cosmopotamian/DIY-LAPTOP/HARDWARE/A64-TERES/TERES-PCB1-A64-MAIN/Rev.C/TERES_PCB1-A64-MAIN_Rev.C.kicad_pcb

## KiCad design HARDWARE/A64-TERES/TERES-PCB1-A64-MAIN/Rev.C/TERES_PCB1-A64-MAIN_Rev.C.kicad_pcb (2025-03-08)

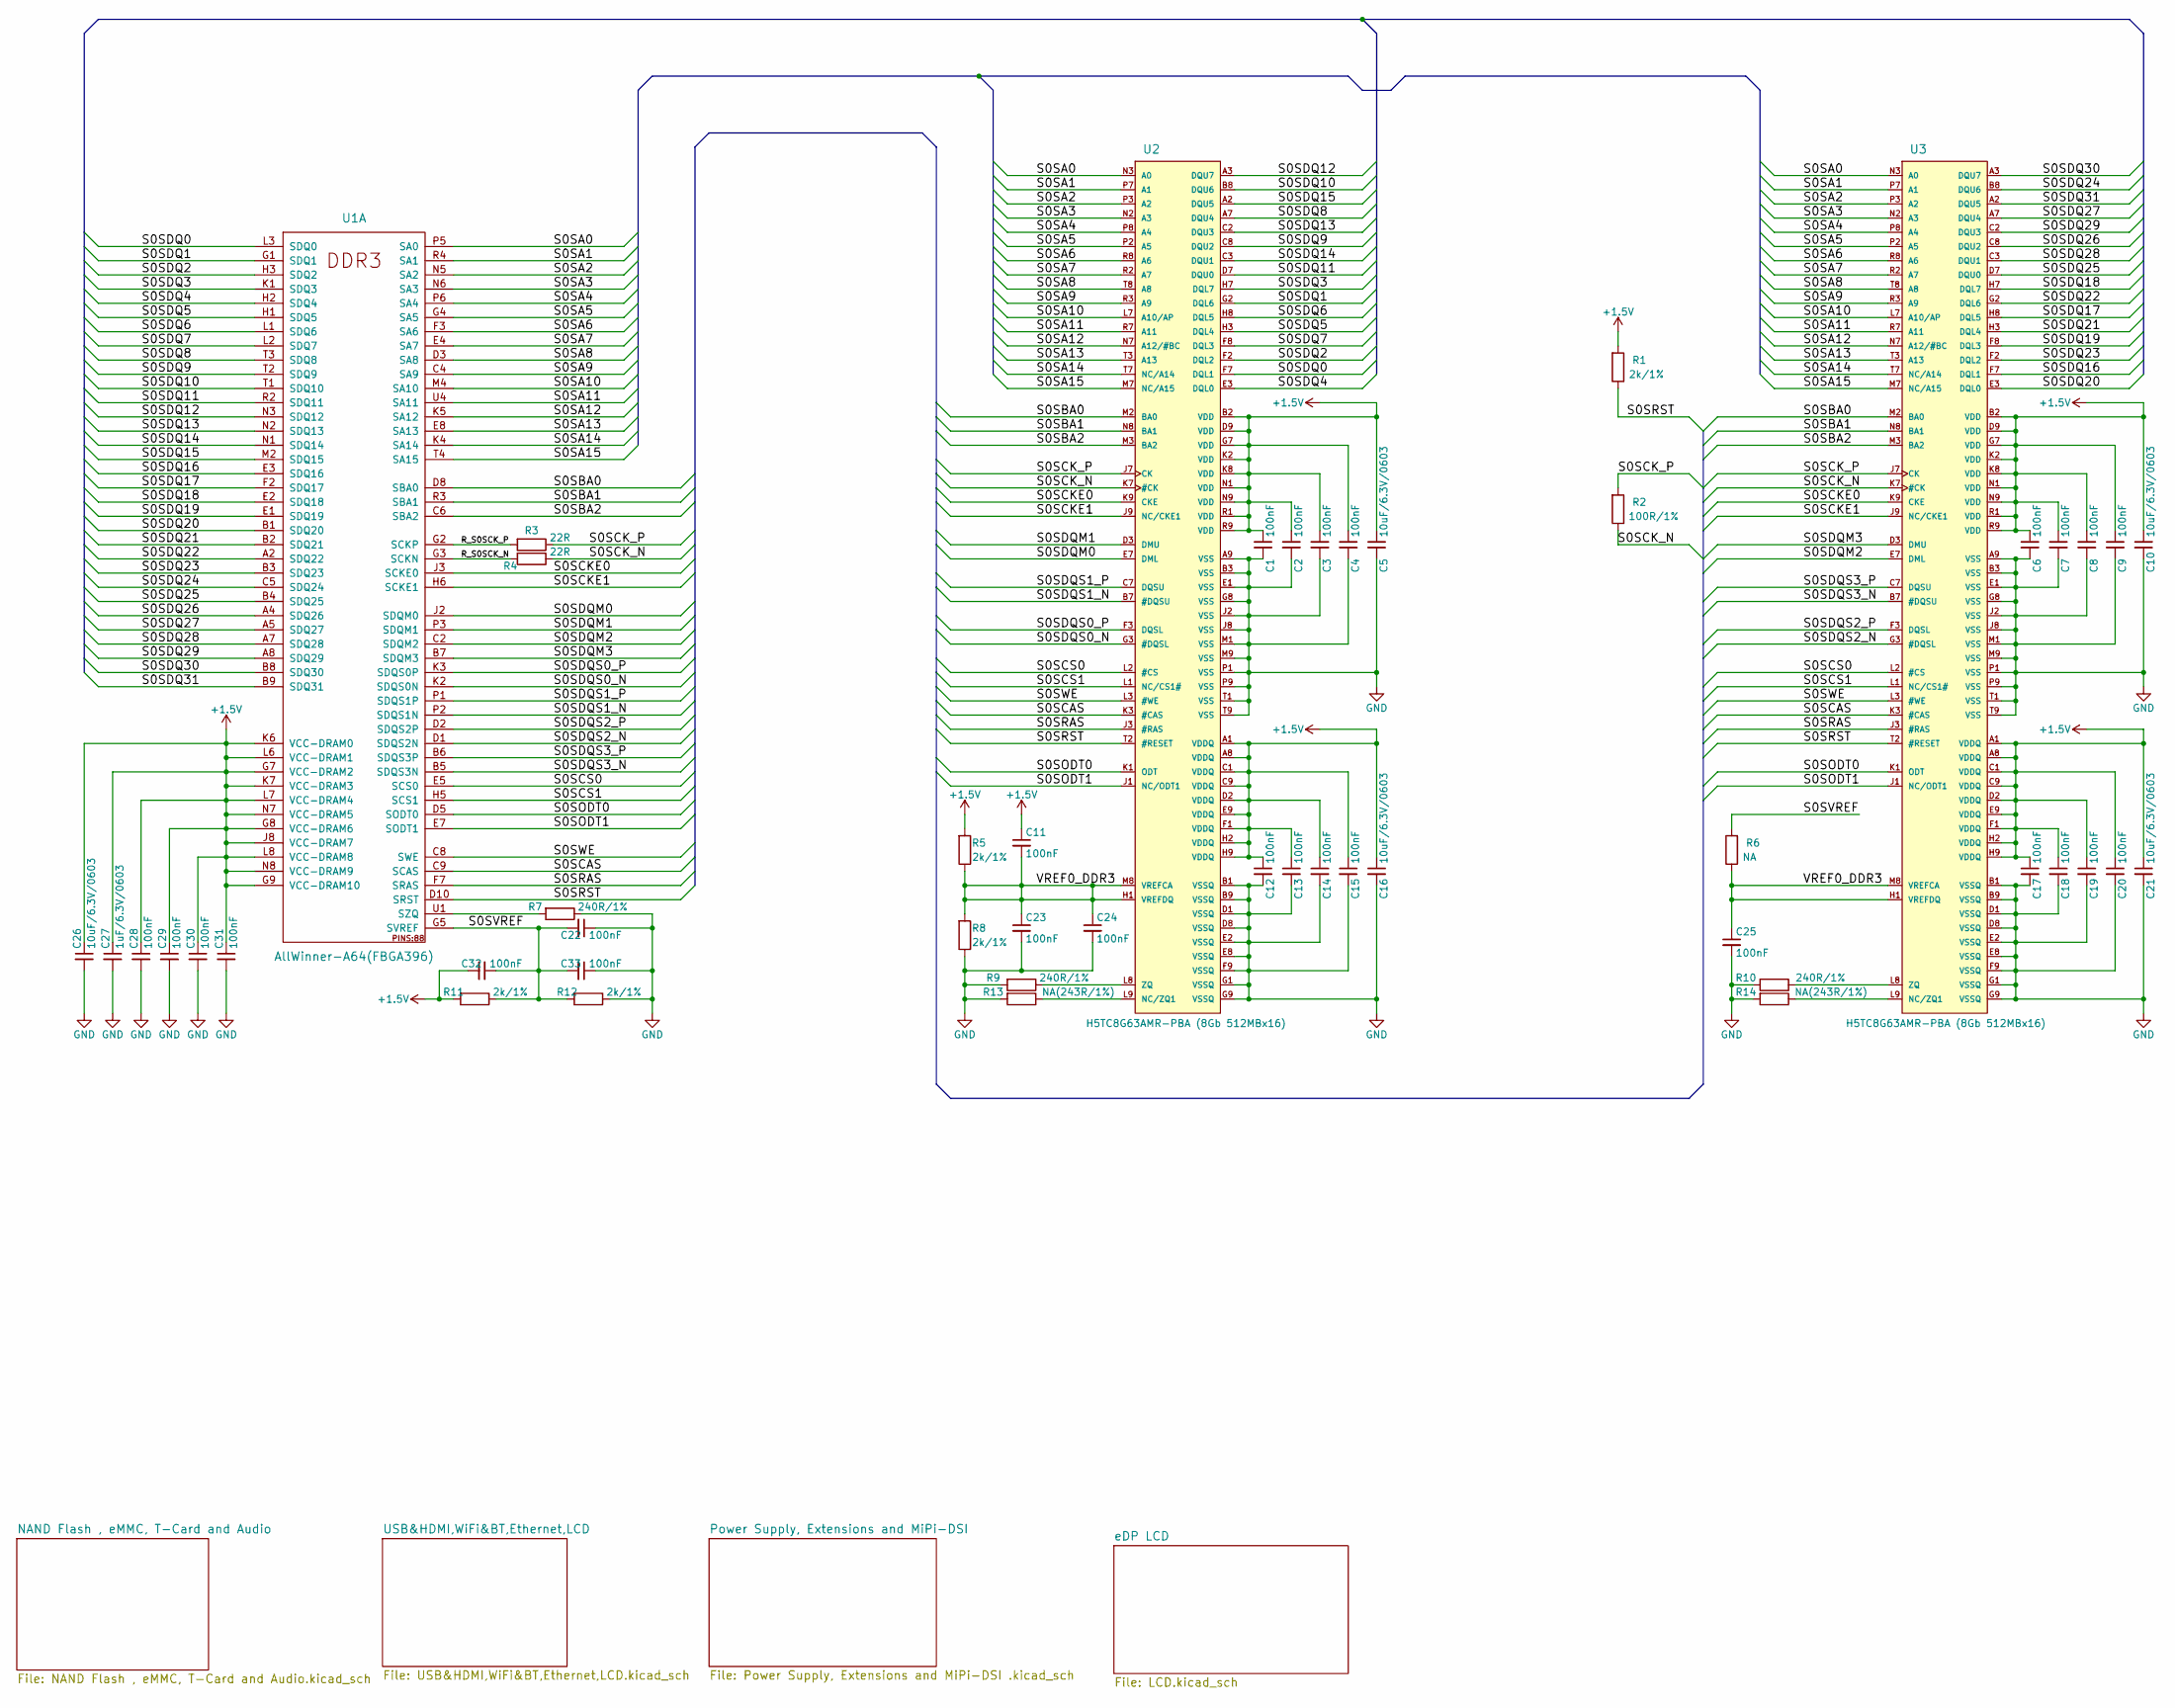
[picture p1: schematic TERES_PCB1-A64-MAIN_Rev.C.kicad_sch, A64-Teres]

Parts:
C1, C2, C3, C4, C6, C7, C8, C9, C11, C12, C13, C14, C15, C17, C18, C19, C20, C22, C23, C24, C25, C28, C29, C30, C31, C32, C33: 100nF; C_0402_5MIL_DWS
C5, C10, C16, C21, C26: 10uF/6.3V/0603; C_0603_5MIL_DWS
C27: 1uF/6.3V/0603; C_0603_5MIL_DWS
R1, R5, R8, R11, R12: 2k/1%; R_0402_5MIL_DWS
R2: 100R/1%; R_0402_5MIL_DWS
R3, R4: 22R; R_0402_5MIL_DWS
R6: NA; R_0402_5MIL_DWS
R7, R9, R10: 240R/1%; R_0402_5MIL_DWS
R13, R14: NA(243R/1%); R_0402_5MIL_DWS
U1: AllWinner-A64(FBGA396); FBGA396
U2, U3: H5TC8G63AMR-PBA (8Gb 512MBx16); FBGA96(HYNIX_SAMSUNG_512MX16_DDR3)

Connections:
+1.5V: C1.1, C2.1, C3.1, C4.1, C5.1, C6.1, C7.1, C8.1, C9.1, C10.1, C11.1, C12.1, C13.1, C14.1, C15.1, C16.1, C17.1, C18.1, C19.1, C20.1, C21.1, C26.1, C27.1, C28.1, C29.1, C30.1, C31.1, C32.2, R1.2, R5.2, R11.2, U1.G7 (VCC-DRAM2), U1.G8 (VCC-DRAM6), U1.G9 (VCC-DRAM10), U1.J8 (VCC-DRAM7), U1.K6 (VCC-DRAM0), U1.K7 (VCC-DRAM3), U1.L6 (VCC-DRAM1), U1.L7 (VCC-DRAM4), U1.L8 (VCC-DRAM8), U1.N7 (VCC-DRAM5), U1.N8 (VCC-DRAM9), U2.A1 (VDDQ), U2.A8 (VDDQ), U2.B2 (VDD), U2.C1 (VDDQ), U2.C9 (VDDQ), U2.D2 (VDDQ), U2.D9 (VDD), U2.E9 (VDDQ), U2.F1 (VDDQ), U2.G7 (VDD), U2.H2 (VDDQ), U2.H9 (VDDQ), U2.K2 (VDD), U2.K8 (VDD), U2.N1 (VDD), U2.N9 (VDD), U2.R1 (VDD), U2.R9 (VDD), U3.A1 (VDDQ), U3.A8 (VDDQ), U3.B2 (VDD), U3.C1 (VDDQ), U3.C9 (VDDQ), U3.D2 (VDDQ), U3.D9 (VDD), U3.E9 (VDDQ), U3.F1 (VDDQ), U3.G7 (VDD), U3.H2 (VDDQ), U3.H9 (VDDQ), U3.K2 (VDD), U3.K8 (VDD), U3.N1 (VDD), U3.N9 (VDD), U3.R1 (VDD), U3.R9 (VDD); also elsewhere on the board
/R_S0SCK_N: R4.2, U1.G3 (SCKN)
/R_S0SCK_P: R3.2, U1.G2 (SCKP)
/S0SA0: U1.P5 (SA0), U2.N3 (A0), U3.N3 (A0)
/S0SA1: U1.R4 (SA1), U2.P7 (A1), U3.P7 (A1)
/S0SA2: U1.N5 (SA2), U2.P3 (A2), U3.P3 (A2)
/S0SA3: U1.N6 (SA3), U2.N2 (A3), U3.N2 (A3)
/S0SA4: U1.P6 (SA4), U2.P8 (A4), U3.P8 (A4)
/S0SA5: U1.G4 (SA5), U2.P2 (A5), U3.P2 (A5)
/S0SA6: U1.F3 (SA6), U2.R8 (A6), U3.R8 (A6)
/S0SA7: U1.E4 (SA7), U2.R2 (A7), U3.R2 (A7)
/S0SA8: U1.D3 (SA8), U2.T8 (A8), U3.T8 (A8)
/S0SA9: U1.C4 (SA9), U2.R3 (A9), U3.R3 (A9)
/S0SA10: U1.M4 (SA10), U2.L7 (A10/AP), U3.L7 (A10/AP)
/S0SA11: U1.U4 (SA11), U2.R7 (A11), U3.R7 (A11)
/S0SA12: U1.K5 (SA12), U2.N7 (A12/#BC), U3.N7 (A12/#BC)
/S0SA13: U1.E8 (SA13), U2.T3 (A13), U3.T3 (A13)
/S0SA14: U1.K4 (SA14), U2.T7 (NC/A14), U3.T7 (NC/A14)
/S0SA15: U1.T4 (SA15), U2.M7 (NC/A15), U3.M7 (NC/A15)
/S0SBA0: U1.D8 (SBA0), U2.M2 (BA0), U3.M2 (BA0)
/S0SBA1: U1.R3 (SBA1), U2.N8 (BA1), U3.N8 (BA1)
/S0SBA2: U1.C6 (SBA2), U2.M3 (BA2), U3.M3 (BA2)
/S0SCAS: U1.C9 (SCAS), U2.K3 (#CAS), U3.K3 (#CAS)
/S0SCKE0: U1.J3 (SCKE0), U2.K9 (CKE), U3.K9 (CKE)
/S0SCKE1: U1.H6 (SCKE1), U2.J9 (NC/CKE1), U3.J9 (NC/CKE1)
/S0SCK_N: R2.1, R4.1, U2.K7 (#CK), U3.K7 (#CK)
/S0SCK_P: R2.2, R3.1, U2.J7 (CK), U3.J7 (CK)
/S0SCS0: U1.E5 (SCS0), U2.L2 (#CS), U3.L2 (#CS)
/S0SCS1: U1.H5 (SCS1), U2.L1 (NC/CS1#), U3.L1 (NC/CS1#)
/S0SDQ0: U1.L3 (SDQ0), U2.F7 (DQL1)
/S0SDQ1: U1.G1 (SDQ1), U2.G2 (DQL6)
/S0SDQ2: U1.H3 (SDQ2), U2.F2 (DQL2)
/S0SDQ3: U1.K1 (SDQ3), U2.H7 (DQL7)
/S0SDQ4: U1.H2 (SDQ4), U2.E3 (DQL0)
/S0SDQ5: U1.H1 (SDQ5), U2.H3 (DQL4)
/S0SDQ6: U1.L1 (SDQ6), U2.H8 (DQL5)
/S0SDQ7: U1.L2 (SDQ7), U2.F8 (DQL3)
/S0SDQ8: U1.T3 (SDQ8), U2.A7 (DQU4)
/S0SDQ9: U1.T2 (SDQ9), U2.C8 (DQU2)
/S0SDQ10: U1.T1 (SDQ10), U2.B8 (DQU6)
/S0SDQ11: U1.R2 (SDQ11), U2.D7 (DQU0)
/S0SDQ12: U1.N3 (SDQ12), U2.A3 (DQU7)
/S0SDQ13: U1.N2 (SDQ13), U2.C2 (DQU3)
/S0SDQ14: U1.N1 (SDQ14), U2.C3 (DQU1)
/S0SDQ15: U1.M2 (SDQ15), U2.A2 (DQU5)
/S0SDQ16: U1.E3 (SDQ16), U3.F7 (DQL1)
/S0SDQ17: U1.F2 (SDQ17), U3.H8 (DQL5)
/S0SDQ18: U1.E2 (SDQ18), U3.H7 (DQL7)
/S0SDQ19: U1.E1 (SDQ19), U3.F8 (DQL3)
/S0SDQ20: U1.B1 (SDQ20), U3.E3 (DQL0)
/S0SDQ21: U1.B2 (SDQ21), U3.H3 (DQL4)
/S0SDQ22: U1.A2 (SDQ22), U3.G2 (DQL6)
/S0SDQ23: U1.B3 (SDQ23), U3.F2 (DQL2)
/S0SDQ24: U1.C5 (SDQ24), U3.B8 (DQU6)
/S0SDQ25: U1.B4 (SDQ25), U3.D7 (DQU0)
/S0SDQ26: U1.A4 (SDQ26), U3.C8 (DQU2)
/S0SDQ27: U1.A5 (SDQ27), U3.A7 (DQU4)
/S0SDQ28: U1.A7 (SDQ28), U3.C3 (DQU1)
/S0SDQ29: U1.A8 (SDQ29), U3.C2 (DQU3)
/S0SDQ30: U1.B8 (SDQ30), U3.A3 (DQU7)
/S0SDQ31: U1.B9 (SDQ31), U3.A2 (DQU5)
/S0SDQM0: U1.J2 (SDQM0), U2.E7 (DML)
/S0SDQM1: U1.P3 (SDQM1), U2.D3 (DMU)
/S0SDQM2: U1.C2 (SDQM2), U3.E7 (DML)
/S0SDQM3: U1.B7 (SDQM3), U3.D3 (DMU)
/S0SDQS0_N: U1.K2 (SDQS0N), U2.G3 (#DQSL)
/S0SDQS0_P: U1.K3 (SDQS0P), U2.F3 (DQSL)
/S0SDQS1_N: U1.P2 (SDQS1N), U2.B7 (#DQSU)
/S0SDQS1_P: U1.P1 (SDQS1P), U2.C7 (DQSU)
/S0SDQS2_N: U1.D1 (SDQS2N), U3.G3 (#DQSL)
/S0SDQS2_P: U1.D2 (SDQS2P), U3.F3 (DQSL)
/S0SDQS3_N: U1.B5 (SDQS3N), U3.B7 (#DQSU)
/S0SDQS3_P: U1.B6 (SDQS3P), U3.C7 (DQSU)
/S0SODT0: U1.D5 (SODT0), U2.K1 (ODT), U3.K1 (ODT)
/S0SODT1: U1.E7 (SODT1), U2.J1 (NC/ODT1), U3.J1 (NC/ODT1)
/S0SRAS: U1.F7 (SRAS), U2.J3 (#RAS), U3.J3 (#RAS)
/S0SRST: R1.1, U1.D10 (SRST), U2.T2 (#RESET), U3.T2 (#RESET)
/S0SVREF: C22.2, C32.1, C33.2, R6.2, R11.1, R12.2, U1.G5 (SVREF)
/S0SWE: U1.C8 (SWE), U2.L3 (#WE), U3.L3 (#WE)
/VREF0_DDR3: C11.2, C23.1, C24.1, C25.1, R5.1, R6.1, R8.2, U2.H1 (VREFDQ), U2.M8 (VREFCA), U3.H1 (VREFDQ), U3.M8 (VREFCA)
GND: C1.2, C2.2, C3.2, C4.2, C5.2, C6.2, C7.2, C8.2, C9.2, C10.2, C12.2, C13.2, C14.2, C15.2, C16.2, C17.2, C18.2, C19.2, C20.2, C21.2, C22.1, C23.2, C24.2, C25.2, C26.2, C27.2, C28.2, C29.2, C30.2, C31.2, C33.1, R7.1, R8.1, R9.2, R10.2, R12.1, R13.2, R14.2, U2.A9 (VSS), U2.B1 (VSSQ), U2.B3 (VSS), U2.B9 (VSSQ), U2.D1 (VSSQ), U2.D8 (VSSQ), U2.E1 (VSS), U2.E2 (VSSQ), U2.E8 (VSSQ), U2.F9 (VSSQ), U2.G1 (VSSQ), U2.G8 (VSS), U2.G9 (VSSQ), U2.J2 (VSS), U2.J8 (VSS), U2.M1 (VSS), U2.M9 (VSS), U2.P1 (VSS), U2.P9 (VSS), U2.T1 (VSS), U2.T9 (VSS), U3.A9 (VSS), U3.B1 (VSSQ), U3.B3 (VSS), U3.B9 (VSSQ), U3.D1 (VSSQ), U3.D8 (VSSQ), U3.E1 (VSS), U3.E2 (VSSQ), U3.E8 (VSSQ), U3.F9 (VSSQ), U3.G1 (VSSQ), U3.G8 (VSS), U3.G9 (VSSQ), U3.J2 (VSS), U3.J8 (VSS), U3.M1 (VSS), U3.M9 (VSS), U3.P1 (VSS), U3.P9 (VSS), U3.T1 (VSS), U3.T9 (VSS); also elsewhere on the board
unnamed: R7.2, U1.U1 (SZQ)
unnamed: R9.1, U2.L8 (ZQ)
unnamed: R10.1, U3.L8 (ZQ)
unnamed: R13.1, U2.L9 (NC/ZQ1)
unnamed: R14.1, U3.L9 (NC/ZQ1)

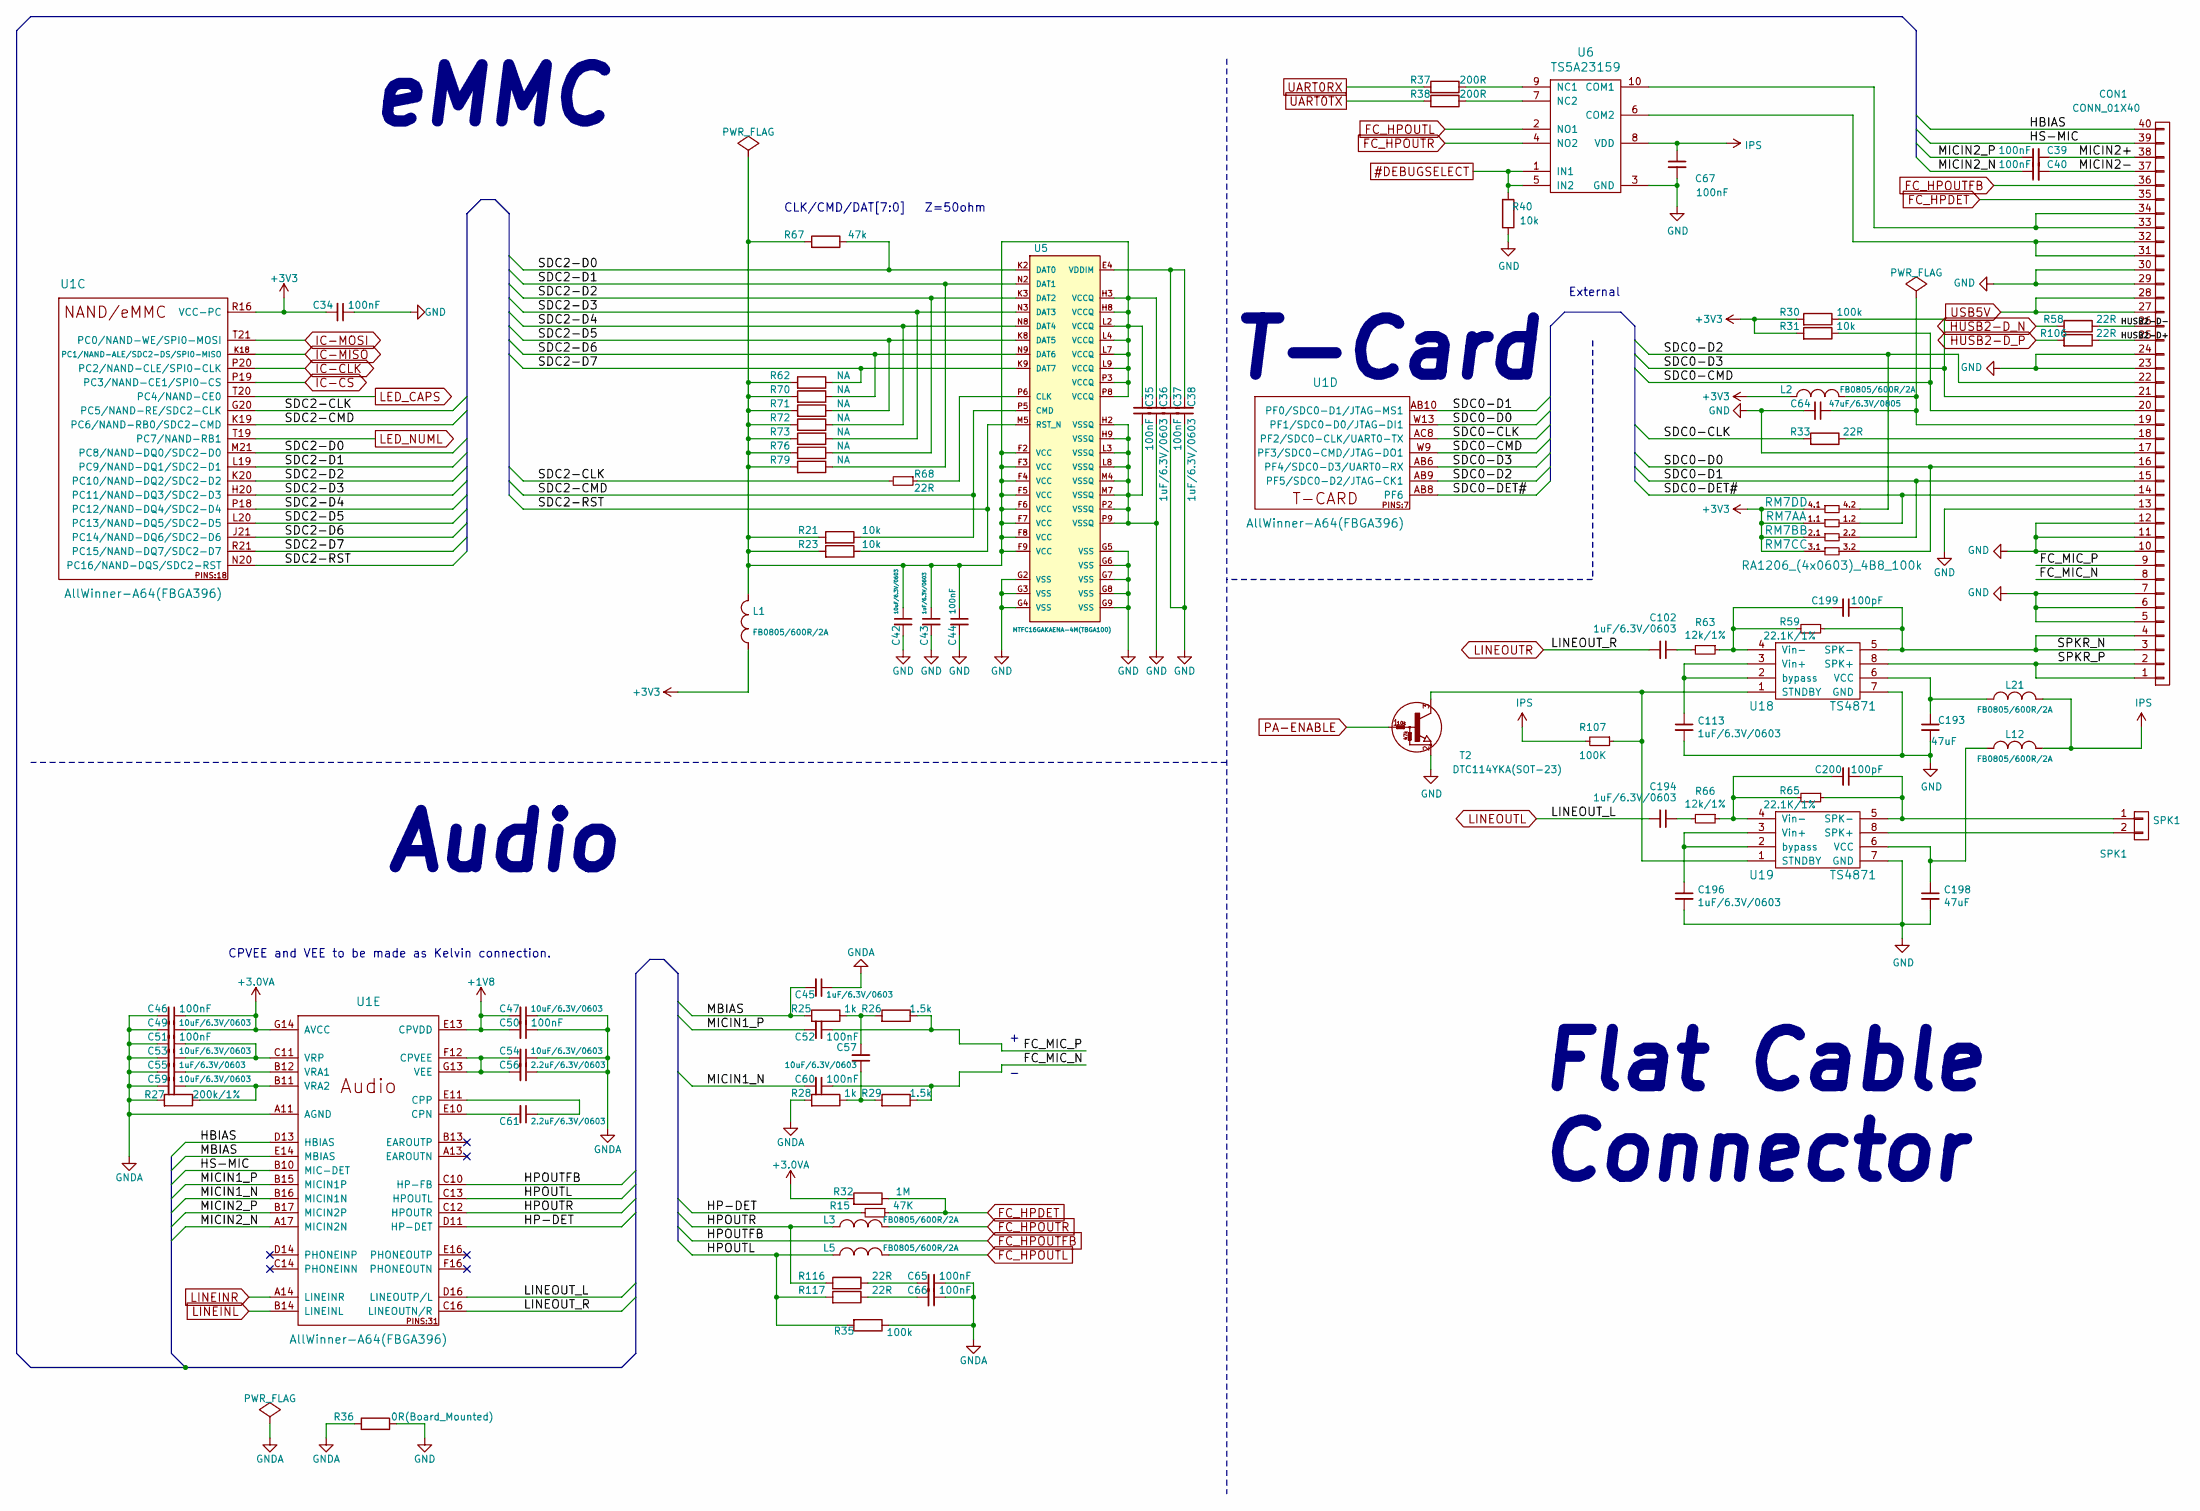
[picture p2: schematic NAND Flash , eMMC, T-Card and Audio.kicad_sch, A64-Teres]

Parts:
C34, C35, C37, C39, C40, C44, C46, C50, C51, C52, C60, C65, C66, C67: 100nF; C_0402_5MIL_DWS
C36, C38, C43, C45, C55, C102, C113, C194, C196: 1uF/6.3V/0603; C_0603_5MIL_DWS
C42, C47, C49, C53, C54, C57, C59: 10uF/6.3V/0603; C_0603_5MIL_DWS
C56, C61: 2.2uF/6.3V/0603; C_0603_5MIL_DWS
C64: 47uF/6.3V/0805; C_0805_5MIL_DWS
C193, C198: 47uF; C_0805_5MIL_DWS
C199, C200: 100pF; C_0402_5MIL_DWS
CON1: CONN_01X40; FPV-WZA21-40-LF
L1, L2, L3, L5, L12, L21: FB0805/600R/2A; L_0805_5MIL_DWS
R15: 47K; R_0402_5MIL_DWS
R21, R23, R31, R40: 10k; R_0402_5MIL_DWS
R25, R28: 1k; R_0402_5MIL_DWS
R26, R29: 1.5k; R_0402_5MIL_DWS
R27: 200k/1%; R_0402_5MIL_DWS
R30, R35: 100k; R_0402_5MIL_DWS
R32: 1M; R_0402_5MIL_DWS
R33, R58, R68, R106, R116, R117: 22R; R_0402_5MIL_DWS
R36: 0R(Board_Mounted); 0R_0603
R37, R38: 200R; R_0402_5MIL_DWS
R59, R65: 22.1K/1%; R_0402_5MIL_DWS
R62, R70, R71, R72, R73, R76, R79: NA; R_0402_5MIL_DWS
R63, R66: 12k/1%; R_0402_5MIL_DWS
R67: 47k; R_0402_5MIL_DWS
R107: 100K; R_0402_5MIL_DWS
RM7A, RM7B: RA1206_(4x0603)_4B8_100k; R_MATRIX_4
RM7C, RM7D: RA1206_(4x0603)_4B8_100k; RA1206_(4X0603)_4B8_xx
SPK1: SPK1; CON-SPK-TERES
T2: DTC114YKA(SOT-23); SOT23
U1: AllWinner-A64(FBGA396); FBGA396
U5: MTFC16GAKAENA-4M(TBGA100); TBGA100
U6: TS5A23159; VSSOP-10
U18, U19: TS4871; SO-8

Connections:
#DEBUGSELECT: R40.2, U6.1 (IN1), U6.5 (IN2); also elsewhere on the board
+1V8: C47.2, C50.2, U1.E13 (CPVDD); also elsewhere on the board
+3.0VA: C46.1, C49.1, R32.2, U1.G14 (AVCC); also elsewhere on the board
+3V3: C34.2, L1.1, L2.1, R30.2, R31.2, RM7A.1.1, RM7B.2.1, RM7C.3.1, RM7D.4.1, U1.R16 (VCC-PC); also elsewhere on the board
/NAND Flash , eMMC, T-Card and Audio/FC_MIC_N: C60.1, CON1.8, R29.1
/NAND Flash , eMMC, T-Card and Audio/FC_MIC_P: C52.1, CON1.9, R26.1
/NAND Flash , eMMC, T-Card and Audio/HBIAS: CON1.40, U1.D13 (HBIAS)
/NAND Flash , eMMC, T-Card and Audio/HP-DET: R15.2, U1.D11 (HP-DET)
/NAND Flash , eMMC, T-Card and Audio/HPOUTL: L5.1, R35.2, R117.2, U1.C13 (HPOUTL)
/NAND Flash , eMMC, T-Card and Audio/HPOUTR: L3.1, R116.2, U1.C12 (HPOUTR)
/NAND Flash , eMMC, T-Card and Audio/HS-MIC: CON1.39, U1.B10 (MIC-DET)
/NAND Flash , eMMC, T-Card and Audio/HUSB2-D+: CON1.25, R106.1
/NAND Flash , eMMC, T-Card and Audio/HUSB2-D-: CON1.26, R58.1
/NAND Flash , eMMC, T-Card and Audio/MBIAS: C45.2, R25.2, U1.E14 (MBIAS)
/NAND Flash , eMMC, T-Card and Audio/MICIN1_N: C60.2, U1.B16 (MICIN1N)
/NAND Flash , eMMC, T-Card and Audio/MICIN1_P: C52.2, U1.B15 (MICIN1P)
/NAND Flash , eMMC, T-Card and Audio/MICIN2+: C39.2, CON1.38
/NAND Flash , eMMC, T-Card and Audio/MICIN2-: C40.2, CON1.37
/NAND Flash , eMMC, T-Card and Audio/MICIN2_N: C40.1, U1.A17 (MICIN2N)
/NAND Flash , eMMC, T-Card and Audio/MICIN2_P: C39.1, U1.B17 (MICIN2P)
/NAND Flash , eMMC, T-Card and Audio/SDC0-CLK: R33.2, U1.AC8 (PF2/SDC0-CLK/UART0-TX)
/NAND Flash , eMMC, T-Card and Audio/SDC0-CMD: CON1.20, R31.1, U1.W9 (PF3/SDC0-CMD/JTAG-DO1)
/NAND Flash , eMMC, T-Card and Audio/SDC0-D0: CON1.16, RM7C.3.2, U1.W13 (PF1/SDC0-D0/JTAG-DI1); also elsewhere on the board
/NAND Flash , eMMC, T-Card and Audio/SDC0-D1: CON1.15, RM7B.2.2, U1.AB10 (PF0/SDC0-D1/JTAG-MS1); also elsewhere on the board
/NAND Flash , eMMC, T-Card and Audio/SDC0-D2: CON1.22, RM7D.4.2, U1.AB9 (PF5/SDC0-D2/JTAG-CK1); also elsewhere on the board
/NAND Flash , eMMC, T-Card and Audio/SDC0-D3: CON1.21, R30.1, U1.AB6 (PF4/SDC0-D3/UART0-RX)
/NAND Flash , eMMC, T-Card and Audio/SDC0-DET#: CON1.14, RM7A.1.2, U1.AB8 (PF6); also elsewhere on the board
/NAND Flash , eMMC, T-Card and Audio/SDC2-CLK: R68.2, U1.G20 (PC5/NAND-RE/SDC2-CLK)
/NAND Flash , eMMC, T-Card and Audio/SDC2-CMD: R21.1, U1.K19 (PC6/NAND-RB0/SDC2-CMD), U5.P5 (CMD)
/NAND Flash , eMMC, T-Card and Audio/SDC2-D0: R67.1, U1.M21 (PC8/NAND-DQ0/SDC2-D0), U5.K2 (DAT0)
/NAND Flash , eMMC, T-Card and Audio/SDC2-D1: R79.1, U1.L19 (PC9/NAND-DQ1/SDC2-D1), U5.N2 (DAT1)
/NAND Flash , eMMC, T-Card and Audio/SDC2-D2: R76.1, U1.K20 (PC10/NAND-DQ2/SDC2-D2), U5.K3 (DAT2)
/NAND Flash , eMMC, T-Card and Audio/SDC2-D3: R73.1, U1.H20 (PC11/NAND-DQ3/SDC2-D3), U5.N3 (DAT3)
/NAND Flash , eMMC, T-Card and Audio/SDC2-D4: R72.1, U1.P18 (PC12/NAND-DQ4/SDC2-D4), U5.N8 (DAT4)
/NAND Flash , eMMC, T-Card and Audio/SDC2-D5: R71.1, U1.L20 (PC13/NAND-DQ5/SDC2-D5), U5.K8 (DAT5)
/NAND Flash , eMMC, T-Card and Audio/SDC2-D6: R70.1, U1.J21 (PC14/NAND-DQ6/SDC2-D6), U5.N9 (DAT6)
/NAND Flash , eMMC, T-Card and Audio/SDC2-D7: R62.1, U1.R21 (PC15/NAND-DQ7/SDC2-D7), U5.K9 (DAT7)
/NAND Flash , eMMC, T-Card and Audio/SDC2-RST: R23.1, U1.N20 (PC16/NAND-DQS/SDC2-RST), U5.M5 (RST_N)
/NAND Flash , eMMC, T-Card and Audio/SPKR_N: C199.1, CON1.3, CON1.4, R59.1, U18.5 (SPK-)
/NAND Flash , eMMC, T-Card and Audio/SPKR_P: CON1.1, CON1.2, U18.8 (SPK+)
FC_HPDET: CON1.35, R15.1, R32.1
FC_HPOUTFB: CON1.36, U1.C10 (HP-FB)
FC_HPOUTL: L5.2, U6.2 (NO1)
FC_HPOUTR: L3.2, U6.4 (NO2)
GND: C34.1, C35.1, C36.1, C37.1, C38.1, C42.2, C43.2, C44.2, C64.2, C67.2, C113.2, C193.2, C196.2, C198.2, CON1.0, CON1.5, CON1.6, CON1.7, CON1.10, CON1.11, CON1.12, CON1.13, CON1.17, CON1.23, CON1.24, CON1.29, CON1.30, R36.1, R40.1, SPK1.0, T2.2 (E), U5.G2 (VSS), U5.G3 (VSS), U5.G4 (VSS), U5.G5 (VSS), U5.G6 (VSS), U5.G7 (VSS), U5.G8 (VSS), U5.G9 (VSS), U5.H2 (VSSQ), U5.H9 (VSSQ), U5.L3 (VSSQ), U5.L8 (VSSQ), U5.M4 (VSSQ), U5.M7 (VSSQ), U5.P2 (VSSQ), U5.P9 (VSSQ), U6.3 (GND), U18.7 (GND), U19.7 (GND); also elsewhere on the board
GNDA: C45.1, C46.2, C47.1, C49.2, C50.1, C51.2, C53.2, C54.1, C55.2, C56.1, C59.2, C65.1, C66.1, R27.2, R28.2, R35.1, R36.2, U1.A11 (AGND)
HUSB2-D_N: R58.2; also elsewhere on the board
HUSB2-D_P: R106.2; also elsewhere on the board
IC-CLK: U1.P20 (PC2/NAND-CLE/SPI0-CLK); also elsewhere on the board
IC-CS: U1.P19 (PC3/NAND-CE1/SPI0-CS); also elsewhere on the board
IC-MISO: U1.K18 (PC1/NAND-ALE/SDC2-DS/SPI0-MISO); also elsewhere on the board
IC-MOSI: U1.T21 (PC0/NAND-WE/SPI0-MOSI); also elsewhere on the board
IPS: C67.1, L12.2, L21.2, R107.2, U6.8 (VDD); also elsewhere on the board
LED_CAPS: U1.T20 (PC4/NAND-CE0); also elsewhere on the board
LED_NUML: U1.T19 (PC7/NAND-RB1); also elsewhere on the board
LINEINL: U1.B14 (LINEINL); also elsewhere on the board
LINEINR: U1.A14 (LINEINR); also elsewhere on the board
LINEOUTL: C194.2, U1.D16 (LINEOUTP/L); also elsewhere on the board
LINEOUTR: C102.2, U1.C16 (LINEOUTN/R); also elsewhere on the board
unnamed: C35.2, C36.2, C42.1, C43.1, C44.1, L1.2, R21.2, R23.2, R62.2, R67.2, R70.2, R71.2, R72.2, R73.2, R76.2, R79.2, U5.F2 (VCC), U5.F3 (VCC), U5.F4 (VCC), U5.F5 (VCC), U5.F6 (VCC), U5.F7 (VCC), U5.F8 (VCC), U5.F9 (VCC), U5.H3 (VCCQ), U5.H8 (VCCQ), U5.L2 (VCCQ), U5.L4 (VCCQ), U5.L7 (VCCQ), U5.L9 (VCCQ), U5.P3 (VCCQ), U5.P8 (VCCQ)
unnamed: C37.2, C38.2, U5.E4 (VDDIM)
unnamed: C51.1, C53.1, U1.C11 (VRP)
unnamed: C54.2, C56.2, U1.F12 (CPVEE), U1.G13 (VEE)
unnamed: C55.1, U1.B12 (VRA1)
unnamed: C57.1, R28.1, R29.2
unnamed: C57.2, R25.1, R26.2
unnamed: C59.1, R27.1, U1.B11 (VRA2)
unnamed: C61.1, U1.E11 (CPP)
unnamed: C61.2, U1.E10 (CPN)
unnamed: C64.1, CON1.19, L2.2
unnamed: C65.2, R116.1
unnamed: C66.2, R117.1
unnamed: C102.1, R63.2
unnamed: C113.1, U18.2 (bypass), U18.3 (Vin+)
unnamed: C193.1, L21.1, U18.6 (VCC)
unnamed: C194.1, R66.2
unnamed: C196.1, U19.2 (bypass), U19.3 (Vin+)
unnamed: C198.1, L12.1, U19.6 (VCC)
unnamed: C199.2, R59.2, R63.1, U18.4 (Vin-)
unnamed: C200.1, R65.1, SPK1.1, U19.5 (SPK-)
unnamed: C200.2, R65.2, R66.1, U19.4 (Vin-)
unnamed: CON1.18, R33.1
unnamed: CON1.31, CON1.32, U6.6 (COM2)
unnamed: CON1.33, CON1.34, U6.10 (COM1)
unnamed: R37.1, U6.9 (NC1)
unnamed: R38.1, U6.7 (NC2)
unnamed: R68.1, U5.P6 (CLK)
unnamed: R107.1, T2.3 (C), U18.1 (STNDBY), U19.1 (STNDBY)
unnamed: SPK1.2, U19.8 (SPK+)
PA-ENABLE: T2.1 (B); also elsewhere on the board
UART0RX: R37.2; also elsewhere on the board
UART0TX: R38.2; also elsewhere on the board
USB5V: CON1.27, CON1.28; also elsewhere on the board

Notes on the sheet:
Audio
T-Card
CPVEE and VEE to be made as Kelvin connection.
CLK/CMD/DAT[7:0] Z=50ohm
External
eMMC
Flat Cable Connector
