cosmopotamian/DIY-LAPTOP/HARDWARE/A64-TERES/TERES-PCB1-A64-MAIN/Rev.C/TERES_PCB1-A64-MAIN_Rev.C.kicad_pcb

## KiCad design HARDWARE/A64-TERES/TERES-PCB1-A64-MAIN/Rev.C/TERES_PCB1-A64-MAIN_Rev.C.kicad_pcb (continued)

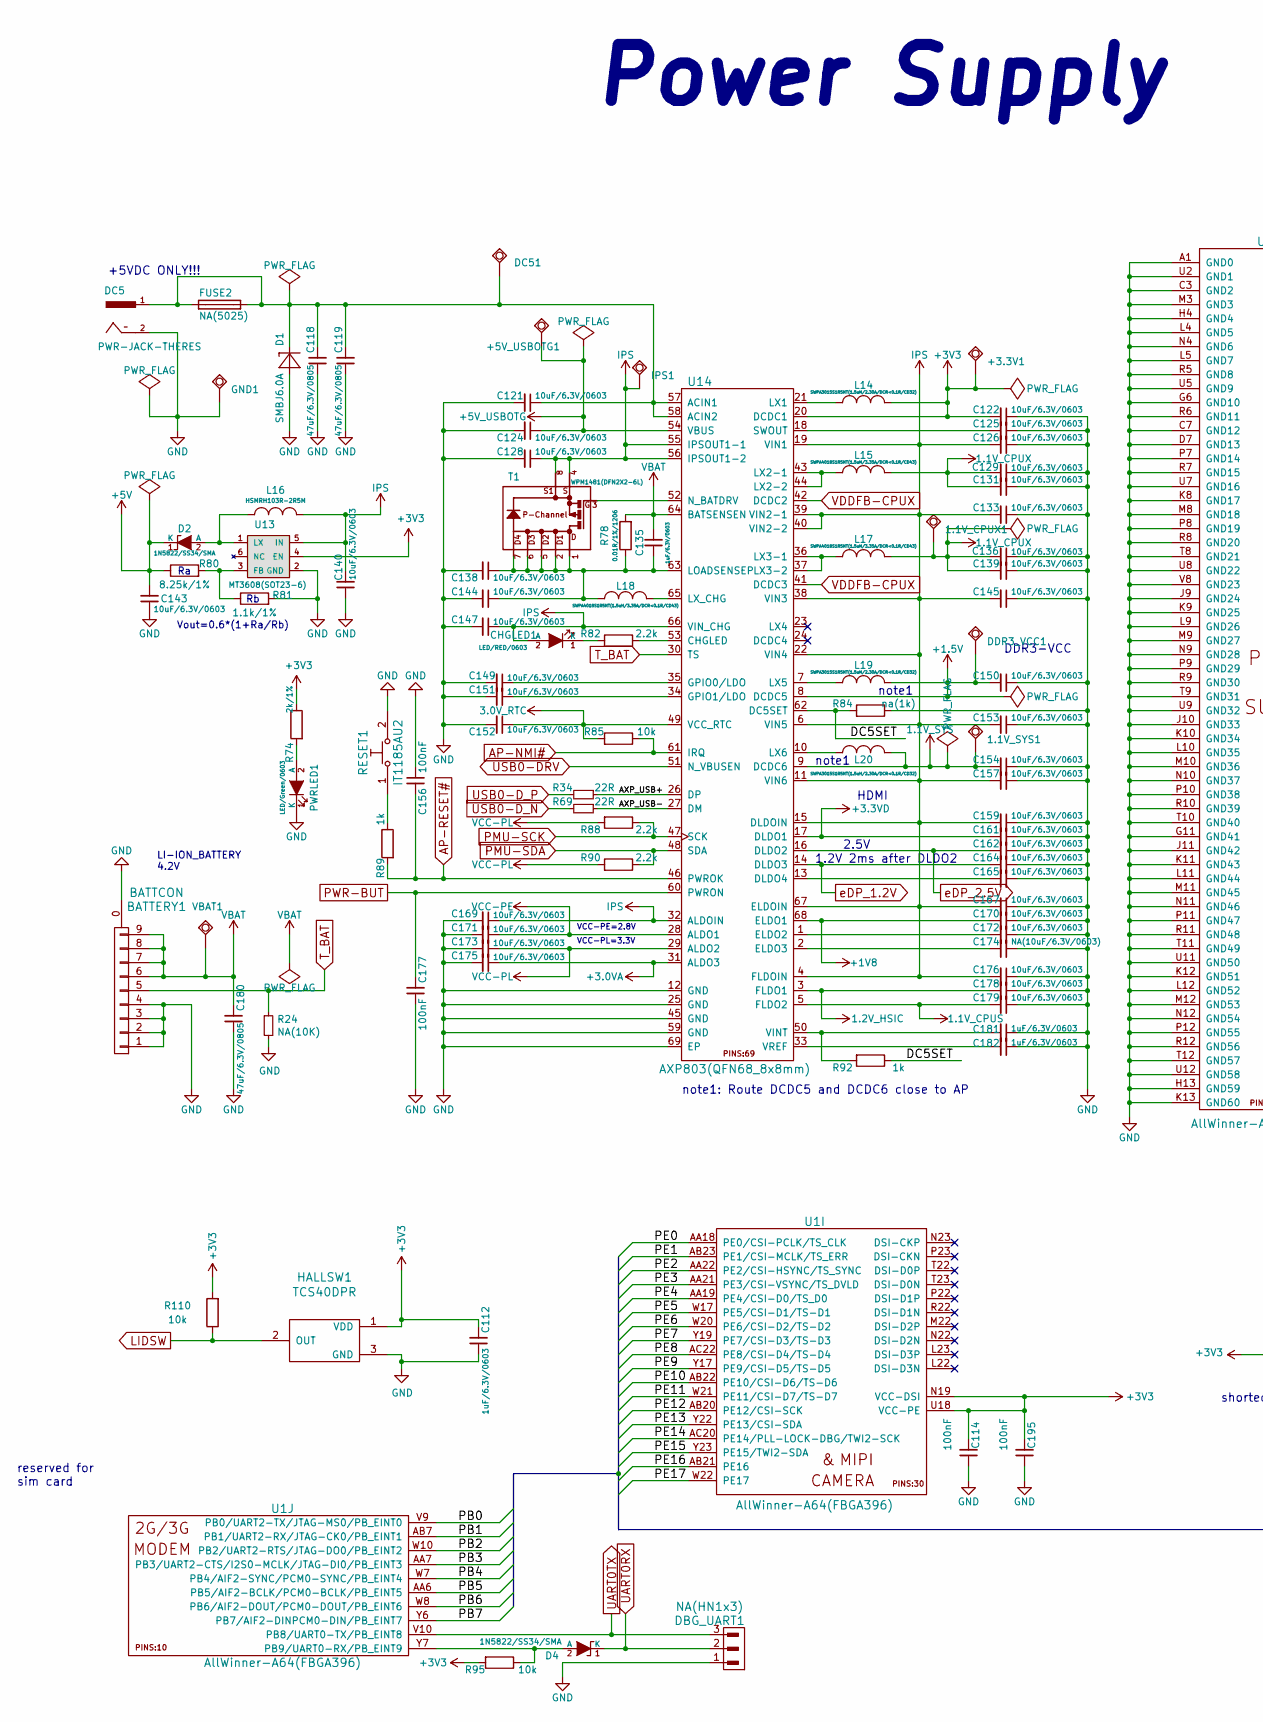
[picture p3: schematic Power Supply, Extensions and MiPi-DSI .kicad_sch, A64-Teres, part in row 1, column 1]

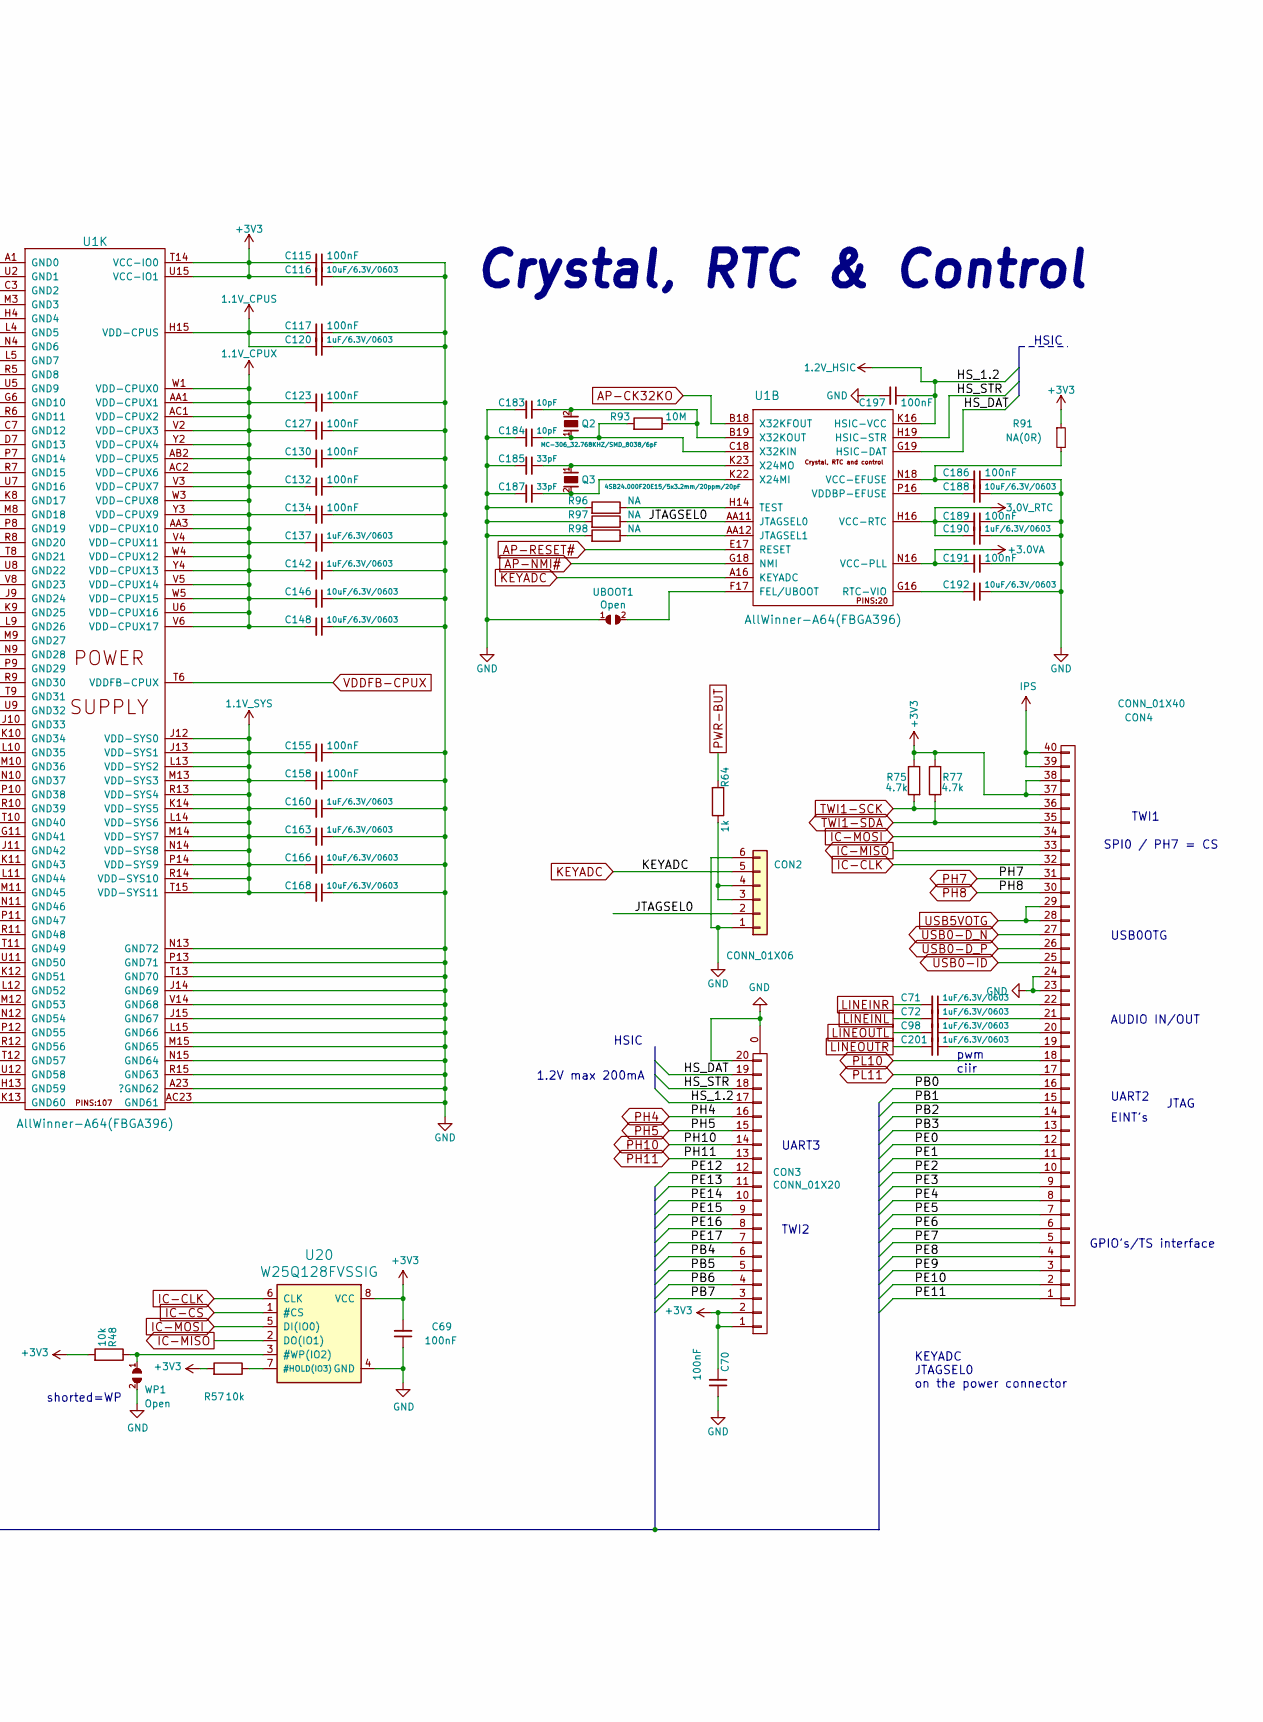
[picture p4: schematic Power Supply, Extensions and MiPi-DSI .kicad_sch, A64-Teres, part in row 1, column 2]

Parts:
1.1V_CPUX1, 1.1V_SYS1: TESTPAD; TESTPAD_40-ROUND
+3.3V1: TESTPAD; TESTPAD_40-ROUND
+5V_USBOTG1: +5V_USBOTG; TESTPAD_40-ROUND
BATTERY1: BATTCON; BATCONN-TERES
C69, C70, C114, C115, C117, C123, C127, C130, C132, C134, C155, C156, C158, C177, C186, C189, C191, C195, C197: 100nF; C_0402_5MIL_DWS
C71, C72, C98, C112, C120, C135, C137, C142, C160, C163, C181, C182, C190, C201: 1uF/6.3V/0603; C_0603_5MIL_DWS
C116, C121, C122, C124, C125, C126, C128, C129, C131, C133, C136, C138, C139, C140, C143, C144, C145, C146, C147, C148, C149, C150, C151, C152, C153, C154, C157, C159, C161, C162, C164, C165, C166, C167, C168, C169, C170, C171, C172, C173, C175, C176, C178, C179, C188, C192: 10uF/6.3V/0603; C_0603_5MIL_DWS
C118, C119, C180: 47uF/6.3V/0805; C_0805_5MIL_DWS
C174: NA(10uF/6.3V/0603); C_0603_5MIL_DWS
C183, C184: 10pF; C_0402_5MIL_DWS
C185, C187: 33pF; C_0402_5MIL_DWS
CHGLED1: LED/RED/0603; LED_0603_KA
CON2: CONN_01X06; FLEXCON-0.5-6
CON3: CONN_01X20; FPV-WZA21-20-LF
CON4: CONN_01X40; FPV-WZA21-40-LF
D1: SMBJ6.0A; DO214AA
D2, D4: 1N5822/SS34/SMA; SMA-KA
DBG_UART1: NA(HN1x3); HN1x3(SMD)
DC5: PWR-JACK-THERES; DC-055-TERES
DC51: TESTPAD; TESTPAD_40-ROUND
DDR3_VCC1: TESTPAD; TESTPAD_40-ROUND
FUSE2: NA(5025); FUSE-5025
GND1: TESTPAD; TESTPAD_40-ROUND
HALLSW1: TCS40DPR; SOT23
IPS1: TESTPAD; TESTPAD_40-ROUND
L14, L19, L20: SWPA3015S1R5NT(1.5uH/2.30A/DCR<0.1R/CD32); CD32
L15, L17, L18: SWPA4018S1R5NT(1.5uH/3.35A/DCR<0.1R/CD43); CD42(43)
L16: HSMRH103R-2R5M; HSMRH103R
PWRLED1: LED/Green/0603; LED_0603_KA
Q2: MC-306_32.768KHZ/SMD_8038/6pF; MC306-HS
Q3: 4SB24.000F20E15/5x3.2mm/20ppm/20pF; Q5x3.25
R24: NA(10K); R_0402_5MIL_DWS
R34, R69: 22R; R_0402_5MIL_DWS
R48, R57, R85, R95, R110: 10k; R_0402_5MIL_DWS
R64, R89, R92: 1k; R_0402_5MIL_DWS
R74: 2k/1%; R_0402_5MIL_DWS
R75, R77: 4.7k; R_0402_5MIL_DWS
R78: 0.01R/1%/1206; R_1206_5MIL_DWS
R80: 8.25k/1%; R_0402_5MIL_DWS
R81: 1.1k/1%; R_0402_5MIL_DWS
R82, R88, R90: 2.2k; R_0402_5MIL_DWS
R84: na(1k); R_0402_5MIL_DWS
R91: NA(0R); R_0402_5MIL_DWS
R93: 10M; R_0402_5MIL_DWS
R96, R97, R98: NA; R_0402_5MIL_DWS
RESET1: IT1185AU2; uTACTIL
T1: WPM1481(DFN2X2-6L); DFN2x2-6L
U1: AllWinner-A64(FBGA396); FBGA396
U13: MT3608(SOT23-6); SOT23-6
U14: AXP803(QFN68_8x8mm); QFN68
U20: W25Q128FVSSIG; SO-8_208mil
UBOOT1: Open; SJ
VBAT1: TESTPAD; TESTPAD_40-ROUND
WP1: Open; SJ

Connections:
1.1V_CPUS: C117.2, C120.2, C179.2, U1.H15 (VDD-CPUS), U14.5 (FLDO2)
1.1V_CPUX: 1.1V_CPUX1.1, C123.2, C127.2, C129.2, C130.2, C131.2, C132.2, C134.2, C136.2, C137.2, C139.2, C142.2, C146.2, C148.2, L15.2, L17.2, U1.AA1 (VDD-CPUX1), U1.AA3 (VDD-CPUX10), U1.AB2 (VDD-CPUX5), U1.AC1 (VDD-CPUX2), U1.AC2 (VDD-CPUX6), U1.U6 (VDD-CPUX16), U1.V2 (VDD-CPUX3), U1.V3 (VDD-CPUX7), U1.V4 (VDD-CPUX11), U1.V5 (VDD-CPUX14), U1.V6 (VDD-CPUX17), U1.W1 (VDD-CPUX0), U1.W3 (VDD-CPUX8), U1.W4 (VDD-CPUX12), U1.W5 (VDD-CPUX15), U1.Y2 (VDD-CPUX4), U1.Y3 (VDD-CPUX9), U1.Y4 (VDD-CPUX13)
1.1V_SYS: 1.1V_SYS1.1, C154.2, C155.2, C158.2, C160.2, C163.2, C166.2, C168.2, L20.2, U1.J12 (VDD-SYS0), U1.J13 (VDD-SYS1), U1.K14 (VDD-SYS5), U1.L13 (VDD-SYS2), U1.L14 (VDD-SYS6), U1.M13 (VDD-SYS3), U1.M14 (VDD-SYS7), U1.N14 (VDD-SYS8), U1.P14 (VDD-SYS9), U1.R13 (VDD-SYS4), U1.R14 (VDD-SYS10), U1.T15 (VDD-SYS11), U14.9 (DCDC6)
1.2V_HSIC: C178.2, C197.1, CON3.17, U1.K16 (HSIC-VCC), U14.3 (FLDO1)
3.0V_RTC: C152.1, C189.2, C190.2, R85.2, U1.H16 (VCC-RTC), U14.49 (VCC_RTC)
+1.5V: C150.2, DDR3_VCC1.1, L19.2, U14.8 (DCDC5); also elsewhere on the board
+1V8: C170.2, U14.68 (ELDO1); also elsewhere on the board
+3.0VA: C175.1, C191.2, U1.N16 (VCC-PLL), U14.31 (ALDO3); also elsewhere on the board
+3.3VD: C161.2, U14.17 (DLDO1); also elsewhere on the board
+3V3: +3.3V1.1, C69.2, C70.2, C112.2, C114.2, C115.2, C116.2, C122.2, C195.2, CON3.1, CON3.2, CON4.37, CON4.38, HALLSW1.1 (VDD), L14.2, R48.2, R57.2, R74.1, R75.1, R77.1, R91.1, R95.2, R110.2, U1.N19 (VCC-DSI), U1.T14 (VCC-IO0), U1.U15 (VCC-IO1), U1.U18 (VCC-PE), U13.4 (EN), U14.20 (DCDC1), U20.8 (VCC); also elsewhere on the board
+5V: C143.2, D2.1 (K), R80.1; also elsewhere on the board
/Power Supply, Extensions and MiPi-DSI/AXP_USB+: R34.1, U14.26 (DP)
/Power Supply, Extensions and MiPi-DSI/AXP_USB-: R69.1, U14.27 (DM)
/Power Supply, Extensions and MiPi-DSI/DC5SET: R84.2, R92.1, U14.62 (DC5SET)
/Power Supply, Extensions and MiPi-DSI/HS_DAT: CON3.19, U1.G19 (HSIC-DAT)
/Power Supply, Extensions and MiPi-DSI/HS_STR: CON3.18, U1.H19 (HSIC-STR)
/Power Supply, Extensions and MiPi-DSI/JTAGSEL0: CON2.2, R97.1, U1.AA11 (JTAGSEL0)
/Power Supply, Extensions and MiPi-DSI/PB0: CON4.16, U1.V9 (PB0/UART2-TX/JTAG-MS0/PB_EINT0)
/Power Supply, Extensions and MiPi-DSI/PB1: CON4.15, U1.AB7 (PB1/UART2-RX/JTAG-CK0/PB_EINT1)
/Power Supply, Extensions and MiPi-DSI/PB2: CON4.14, U1.W10 (PB2/UART2-RTS/JTAG-DO0/PB_EINT2)
/Power Supply, Extensions and MiPi-DSI/PB3: CON4.13, U1.AA7 (PB3/UART2-CTS/I2S0-MCLK/JTAG-DI0/PB_EIN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)
/Power Supply, Extensions and MiPi-DSI/PB4: CON3.6, U1.W7 (PB4/AIF2-SYNC/PCM0-SYNC/PB_EINT4)
/Power Supply, Extensions and MiPi-DSI/PB5: CON3.5, U1.AA6 (PB5/AIF2-BCLK/PCM0-BCLK/PB_EINT5)
/Power Supply, Extensions and MiPi-DSI/PB6: CON3.4, U1.W8 (PB6/AIF2-DOUT/PCM0-DOUT/PB_EINT6)
/Power Supply, Extensions and MiPi-DSI/PB7: CON3.3, U1.Y6 (PB7/AIF2-DINPCM0-DIN/PB_EINT7)
/Power Supply, Extensions and MiPi-DSI/PE0: CON4.12, U1.AA18 (PE0/CSI-PCLK/TS_CLK)
/Power Supply, Extensions and MiPi-DSI/PE1: CON4.11, U1.AB23 (PE1/CSI-MCLK/TS_ERR)
/Power Supply, Extensions and MiPi-DSI/PE2: CON4.10, U1.AA22 (PE2/CSI-HSYNC/TS_SYNC)
/Power Supply, Extensions and MiPi-DSI/PE3: CON4.9, U1.AA21 (PE3/CSI-VSYNC/TS_DVLD)
/Power Supply, Extensions and MiPi-DSI/PE4: CON4.8, U1.AA19 (PE4/CSI-D0/TS_D0)
/Power Supply, Extensions and MiPi-DSI/PE5: CON4.7, U1.W17 (PE5/CSI-D1/TS-D1)
/Power Supply, Extensions and MiPi-DSI/PE6: CON4.6, U1.W20 (PE6/CSI-D2/TS-D2)
/Power Supply, Extensions and MiPi-DSI/PE7: CON4.5, U1.Y19 (PE7/CSI-D3/TS-D3)
/Power Supply, Extensions and MiPi-DSI/PE8: CON4.4, U1.AC22 (PE8/CSI-D4/TS-D4)
/Power Supply, Extensions and MiPi-DSI/PE9: CON4.3, U1.Y17 (PE9/CSI-D5/TS-D5)
/Power Supply, Extensions and MiPi-DSI/PE10: CON4.2, U1.AB22 (PE10/CSI-D6/TS-D6)
/Power Supply, Extensions and MiPi-DSI/PE11: CON4.1, U1.W21 (PE11/CSI-D7/TS-D7)
/Power Supply, Extensions and MiPi-DSI/PE12: CON3.12, U1.AB20 (PE12/CSI-SCK)
/Power Supply, Extensions and MiPi-DSI/PE13: CON3.11, U1.Y22 (PE13/CSI-SDA)
/Power Supply, Extensions and MiPi-DSI/PE14: CON3.10, U1.AC20 (PE14/PLL-LOCK-DBG/TWI2-SCK)
/Power Supply, Extensions and MiPi-DSI/PE15: CON3.9, U1.Y23 (PE15/TWI2-SDA)
/Power Supply, Extensions and MiPi-DSI/PE16: CON3.8, U1.AB21 (PE16)
/Power Supply, Extensions and MiPi-DSI/PE17: CON3.7, U1.W22 (PE17)
AP-CK32KO: U1.B18 (X32KFOUT); also elsewhere on the board
AP-NMI#: R85.1, U1.G18 (NMI), U14.61 (IRQ)
AP-RESET#: C156.2, R89.2, U1.E17 (RESET), U14.46 (PWROK)
GND: BATTERY1.0, BATTERY1.1, BATTERY1.2, BATTERY1.3, BATTERY1.4, C69.1, C70.1, C112.1, C114.1, C115.1, C116.1, C117.1, C118.1, C119.1, C120.1, C121.2, C122.1, C123.1, C124.2, C125.1, C126.1, C127.1, C128.2, C129.1, C130.1, C131.1, C132.1, C133.1, C134.1, C136.1, C137.1, C138.2, C139.1, C140.1, C142.1, C143.1, C144.2, C145.1, C146.1, C147.2, C148.1, C149.2, C150.1, C151.2, C152.2, C153.1, C154.1, C155.1, C156.1, C157.1, C158.1, C159.1, C160.1, C161.1, C162.1, C163.1, C164.1, C165.1, C166.1, C167.1, C168.1, C169.2, C170.1, C171.2, C172.1, C173.2, C174.1, C175.2, C176.1, C177.1, C178.1, C179.1, C180.1, C181.1, C182.1, C183.2, C184.2, C185.2, C186.1, C187.2, C188.1, C189.1, C190.1, C191.1, C192.1, C195.1, C197.2, CON2.0, CON2.1, CON2.6, CON3.0, CON3.20, CON4.0, CON4.23, CON4.24, D1.A, DBG_UART1.1, DC5.2 (-), GND1.1, HALLSW1.3 (GND), PWRLED1.1 (K), R24.2, R81.2, R84.1, R96.2, R97.2, R98.2, RESET1.2, U1.A1 (GND0), U1.A23 (?GND62), U1.AC23 (GND61), U1.C3 (GND2), U1.C7 (GND12), U1.D7 (GND13), U1.G6 (GND10), U1.G11 (GND41), U1.H4 (GND4), U1.H13 (GND59), U1.J9 (GND24), U1.J10 (GND33), U1.J11 (GND42), U1.J14 (GND69), U1.J15 (GND67), U1.K8 (GND17), U1.K9 (GND25), U1.K10 (GND34), U1.K11 (GND43), U1.K12 (GND51), U1.K13 (GND60), U1.L4 (GND5), U1.L5 (GND7), U1.L9 (GND26), U1.L10 (GND35), U1.L11 (GND44), U1.L12 (GND52), U1.L15 (GND66), U1.M3 (GND3), U1.M8 (GND18), U1.M9 (GND27), U1.M10 (GND36), U1.M11 (GND45), U1.M12 (GND53), U1.M15 (GND65), U1.N4 (GND6), U1.N9 (GND28), U1.N10 (GND37), U1.N11 (GND46), U1.N12 (GND54), U1.N13 (GND72), U1.N15 (GND64), U1.P7 (GND14), U1.P8 (GND19), U1.P9 (GND29), U1.P10 (GND38), U1.P11 (GND47), U1.P12 (GND55), U1.P13 (GND71), U1.R5 (GND8), U1.R6 (GND11), U1.R7 (GND15), U1.R8 (GND20), U1.R9 (GND30), U1.R10 (GND39), U1.R11 (GND48), U1.R12 (GND56), U1.R15 (GND63), U1.T8 (GND21), U1.T9 (GND31), U1.T10 (GND40), U1.T11 (GND49), U1.T12 (GND57), U1.T13 (GND70), U1.U2 (GND1), U1.U5 (GND9), U1.U7 (GND16), U1.U8 (GND22), U1.U9 (GND32), U1.U11 (GND50), U1.U12 (GND58), U1.V8 (GND23), U1.V14 (GND68), U13.2 (GND), U14.12 (GND), U14.25 (GND), U14.45 (GND), U14.59 (GND), U14.69 (EP), U20.4 (GND), UBOOT1.1, WP1.2; also elsewhere on the board
IC-CLK: CON4.32, U20.6 (CLK); also elsewhere on the board
IC-CS: U20.1 (#CS); also elsewhere on the board
IC-MISO: CON4.33, U20.2 (DO(IO1)); also elsewhere on the board
IC-MOSI: CON4.34, U20.5 (DI(IO0)); also elsewhere on the board
IPS: C126.2, C128.1, C133.2, C140.2, C145.2, C147.1, C153.2, C157.2, C159.2, C167.2, C169.1, C176.2, CHGLED1.2 (A), CON4.39, CON4.40, IPS1.1, L16.1, T1.4 (S), T1.8 (S1), U13.5 (IN), U14.4 (FLDOIN), U14.6 (VIN5), U14.11 (VIN6), U14.15 (DLDOIN), U14.19 (VIN1), U14.22 (VIN4), U14.32 (ALDOIN), U14.38 (VIN3), U14.39 (VIN2-1), U14.40 (VIN2-2), U14.55 (IPSOUT1-1), U14.56 (IPSOUT1-2), U14.66 (VIN_CHG), U14.67 (ELDOIN); also elsewhere on the board
KEYADC: CON2.5, U1.A16 (KEYADC)
LIDSW: HALLSW1.2 (OUT), R110.1; also elsewhere on the board
LINEINL: C72.2; also elsewhere on the board
LINEINR: C71.2; also elsewhere on the board
LINEOUTL: C98.2; also elsewhere on the board
LINEOUTR: C201.2; also elsewhere on the board
unnamed: C71.1, CON4.22
unnamed: C72.1, CON4.21
unnamed: C98.1, CON4.20
unnamed: C118.2, C119.2, C121.1, D1.C, DC5.1 (+), DC51.1, FUSE2.1, FUSE2.2, U14.57 (ACIN1), U14.58 (ACIN2)
unnamed: C125.2, U14.18 (SWOUT)
unnamed: C135.1, C138.1, C144.1, L18.1, R78.1, T1.1 (D), T1.2 (D1), T1.5 (D2), T1.6 (D3), T1.7 (D4), U14.63 (LOADSENSEP)
unnamed: C149.1, U14.35 (GPIO0/LDO)
unnamed: C151.1, U14.34 (GPIO1/LDO)
unnamed: C165.2, U14.13 (DLDO4)
unnamed: C172.2, U14.1 (ELDO2)
unnamed: C174.2, U14.2 (ELDO3)
unnamed: C181.2, R92.2, U14.50 (VINT)
unnamed: C182.2, U14.33 (VREF)
unnamed: C183.1, Q2.2, R93.1, U1.B19 (X32KOUT)
unnamed: C184.1, Q2.1, R93.2, U1.C18 (X32KIN)
unnamed: C185.1, Q3.1, U1.K23 (X24MO)
unnamed: C186.2, R91.2, U1.N18 (VCC-EFUSE)
unnamed: C187.1, Q3.2, U1.K22 (X24MI)
unnamed: C188.2, U1.P16 (VDDBP-EFUSE)
unnamed: C192.2, U1.G16 (RTC-VIO)
unnamed: C201.1, CON4.19
unnamed: CHGLED1.1 (K), R82.2
unnamed: CON2.3, CON2.4, R64.1
unnamed: D2.2 (A), L16.2, U13.1 (LX)
unnamed: D4.2 (A), R95.1, U1.Y7 (PB9/UART0-RX/PB_EINT9)
unnamed: L14.1, U14.21 (LX1)
unnamed: L15.1, U14.43 (LX2-1), U14.44 (LX2-2)
unnamed: L17.1, U14.36 (LX3-1), U14.37 (LX3-2)
unnamed: L18.2, U14.65 (LX_CHG)
unnamed: L19.1, U14.7 (LX5)
unnamed: L20.1, U14.10 (LX6)
unnamed: PWRLED1.2 (A), R74.2
unnamed: R48.1, U20.3 (#WP(IO2)), WP1.1
unnamed: R57.1, U20.7 (#HOLD(IO3))
unnamed: R80.2, R81.1, U13.3 (FB)
unnamed: R82.1, U14.53 (CHGLED)
unnamed: R89.1, RESET1.1
unnamed: R96.1, U1.H14 (TEST)
unnamed: R98.1, U1.AA12 (JTAGSEL1)
unnamed: T1.3 (G), U14.52 (N_BATDRV)
unnamed: U1.F17 (FEL/UBOOT), UBOOT1.2
PH4: CON3.16; also elsewhere on the board
PH5: CON3.15; also elsewhere on the board
PH7: CON4.31; also elsewhere on the board
PH8: CON4.30; also elsewhere on the board
PH10: CON3.14; also elsewhere on the board
PH11: CON3.13; also elsewhere on the board
PL10: CON4.18; also elsewhere on the board
PL11: CON4.17; also elsewhere on the board
PMU-SCK: R88.1, U14.47 (SCK); also elsewhere on the board
PMU-SDA: R90.1, U14.48 (SDA); also elsewhere on the board
PWR-BUT: C177.2, R64.2, U14.60 (PWRON)
TWI1-SCK: CON4.36, R75.2; also elsewhere on the board
TWI1-SDA: CON4.35, R77.2; also elsewhere on the board
T_BAT: BATTERY1.5, R24.1, U14.30 (TS)
UART0RX: D4.1 (K), DBG_UART1.2; also elsewhere on the board
UART0TX: DBG_UART1.3, U1.V10 (PB8/UART0-TX/PB_EINT8); also elsewhere on the board
USB0-DRV: U14.51 (N_VBUSEN); also elsewhere on the board
USB0-D_N: CON4.27, R69.2; also elsewhere on the board
USB0-D_P: CON4.26, R34.2; also elsewhere on the board
USB0-ID: CON4.25; also elsewhere on the board
USB5VOTG: +5V_USBOTG1.1, C124.1, CON4.28, CON4.29, U14.54 (VBUS); also elsewhere on the board
VBAT: BATTERY1.6, BATTERY1.7, BATTERY1.8, BATTERY1.9, C135.2, C180.2, R78.2, U14.64 (BATSENSEN), VBAT1.1
VCC-PE: C171.1, U14.28 (ALDO1)
VCC-PL: C173.1, R88.2, R90.2, U14.29 (ALDO2); also elsewhere on the board
VDDFB-CPUX: U1.T6 (VDDFB-CPUX), U14.41 (DCDC3), U14.42 (DCDC2)
eDP_1.2V: C164.2, U14.14 (DLDO3); also elsewhere on the board
eDP_2.5V: C162.2, U14.16 (DLDO2); also elsewhere on the board

Notes on the sheet:
USB0OTG
DDR3-VCC
note1
HSIC
reserved for sim card
AUDIO IN/OUT
LI-ION_BATTERY 4.2V
1.2V max 200mA
UART2
VCC-PE=2.8V
Crystal, RTC & Control
KEYADC JTAGSEL0 on the power connector
UART3
ciir
note1: Route DCDC5 and DCDC6 close to AP
JTAG
TWI2
Power Supply
pwm
shorted=WP
1.2V 2ms after DLDO2
SPI0 / PH7 = CS
Vout=0.6*(1+Ra/Rb)
HDMI
GPIO's/TS interface
TWI1
2.5V
VCC-PL=3.3V
EINT's
+5VDC ONLY!!!

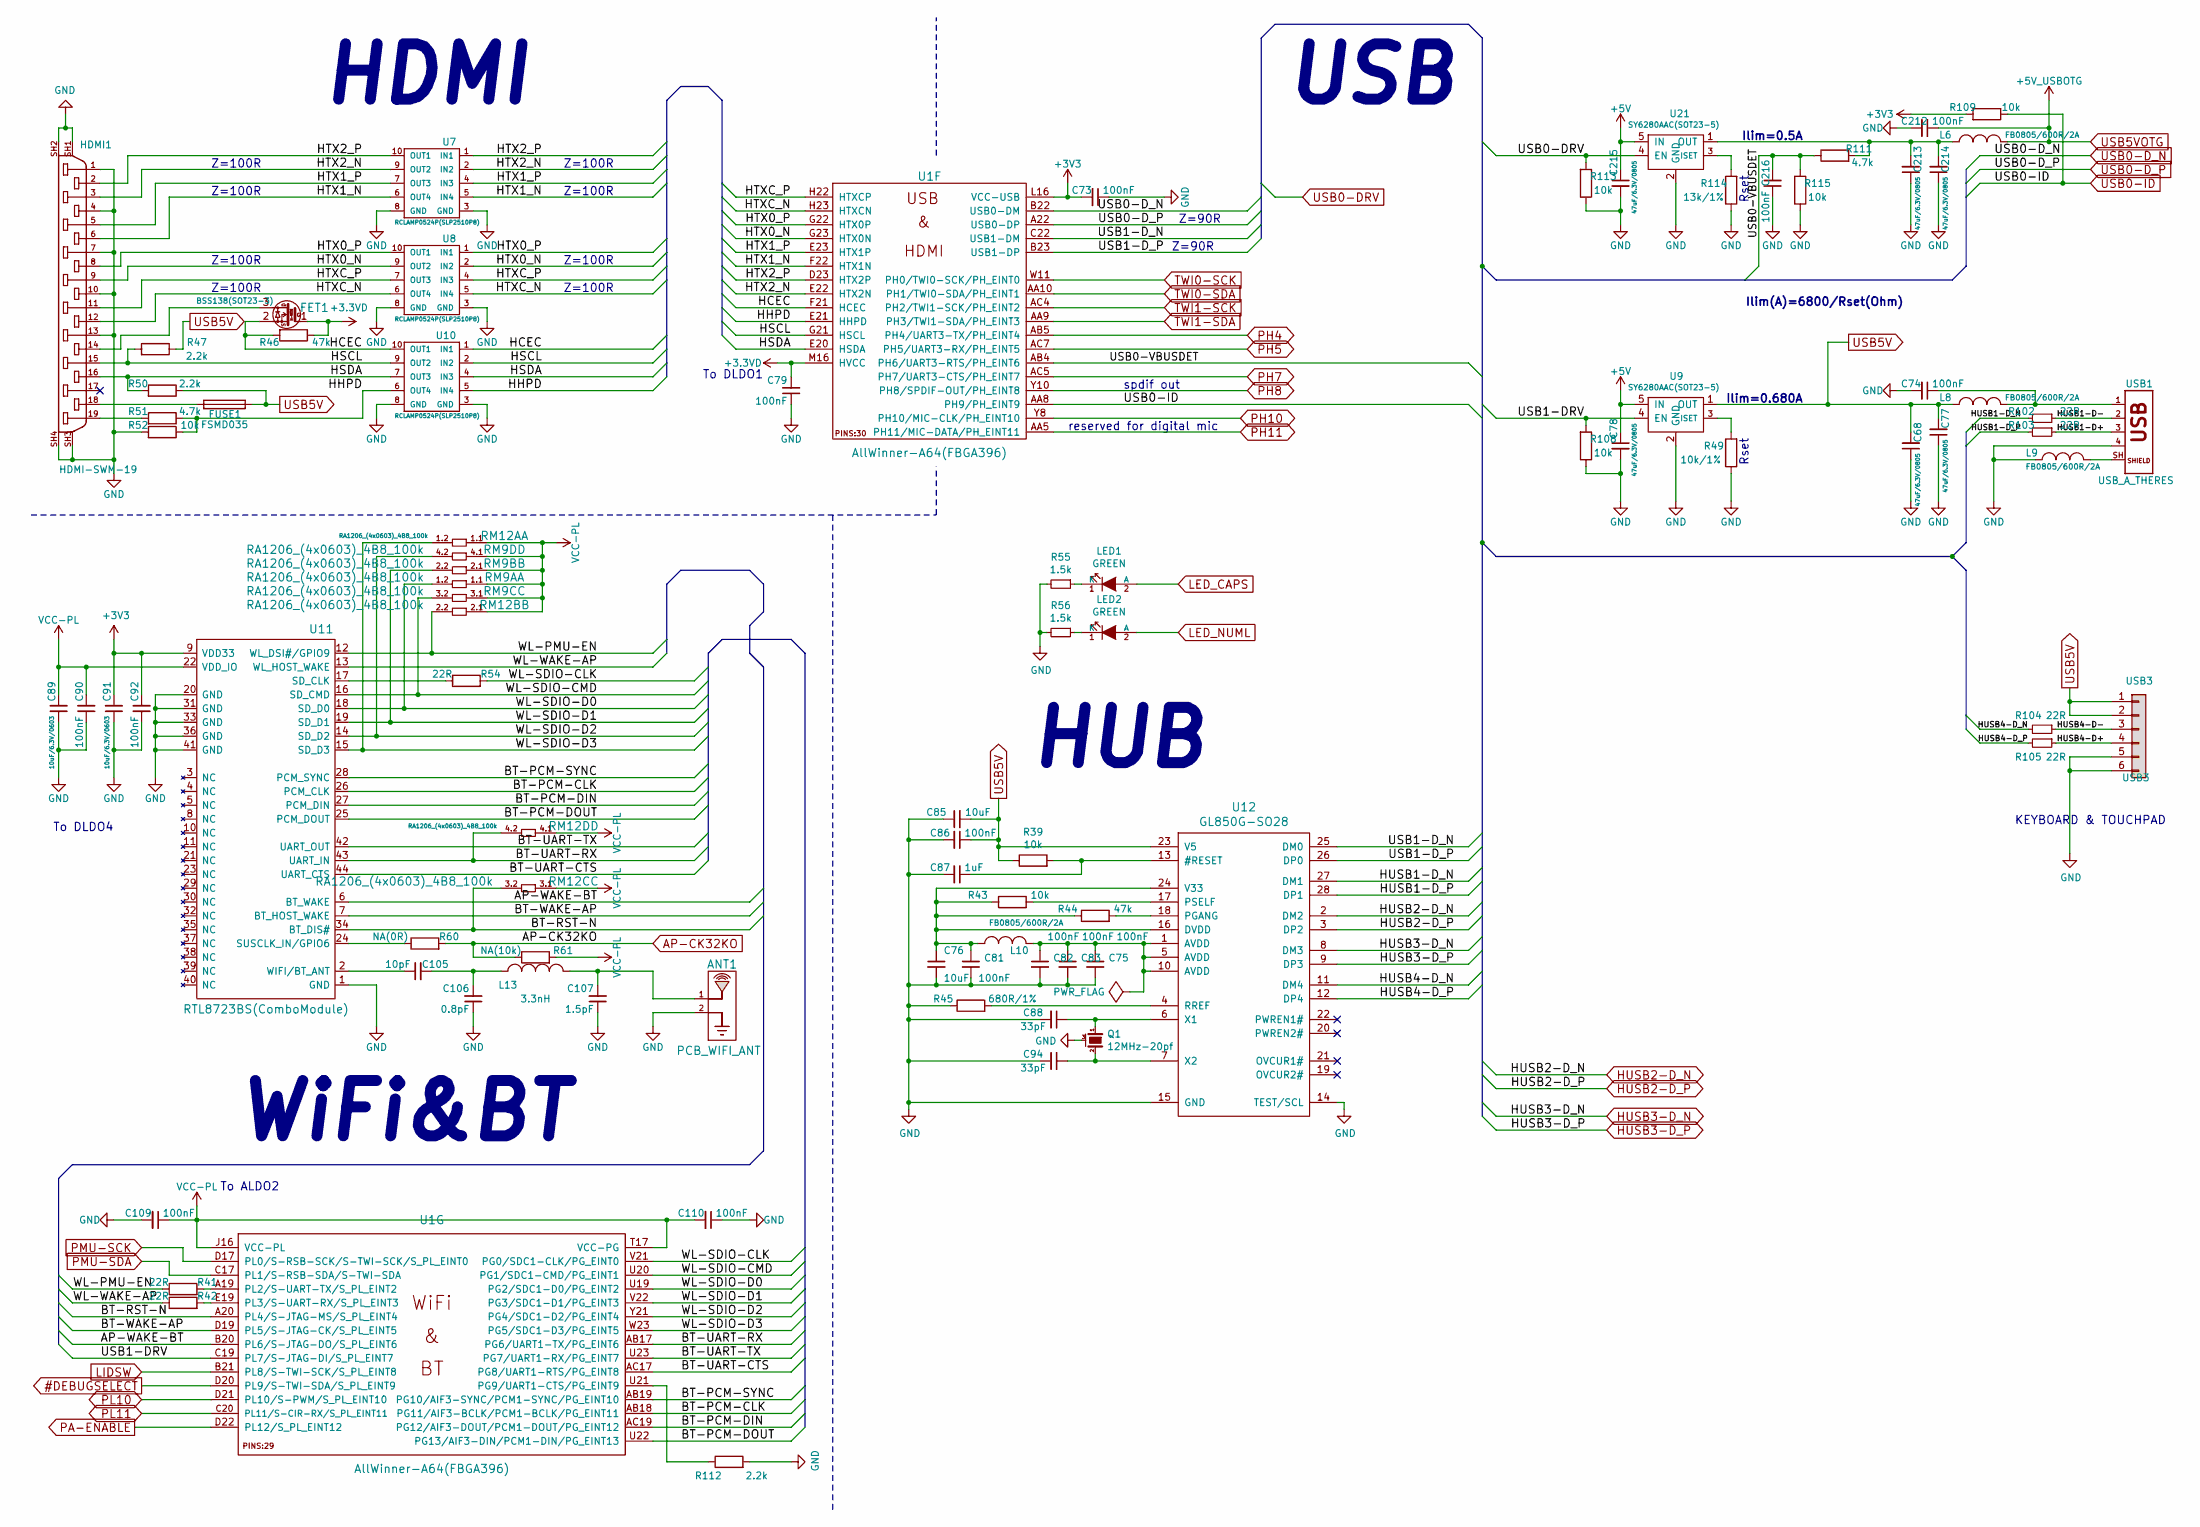
[picture p5: schematic USB&HDMI,WiFi&BT,Ethernet,LCD.kicad_sch, A64-Teres]

Parts:
ANT1: PCB_WIFI_ANT; U.FL-R-SMT-1
C68, C77, C78, C213, C214, C215: 47uF/6.3V/0805; C_0805_5MIL_DWS
C73, C74, C75, C79, C81, C82, C83, C86, C90, C92, C109, C110, C212, C216: 100nF; C_0402_5MIL_DWS
C76: 10uF; C_0603_5MIL_DWS
C85: 10uF; R_0603_5MIL_DWS
C87: 1uF; C_0603_5MIL_DWS
C88, C94: 33pF; C_0402_5MIL_DWS
C89, C91: 10uF/6.3V/0603; C_0603_5MIL_DWS
C105: 10pF; C_0402_5MIL_DWS
C106: 0.8pF; C_0402_5MIL_DWS
C107: 1.5pF; C_0402_5MIL_DWS
FET1: BSS138(SOT23-3); SOT23
FUSE1: FSMD035; FUSE-1206
HDMI1: HDMI-SWM-19; HDMI-MINI-TERES
L6, L8, L9, L10: FB0805/600R/2A; L_0805_5MIL_DWS
L13: 3.3nH; R_0402_5MIL_DWS
LED1, LED2: GREEN; LED_0603_KA
Q1: 12MHz-20pf; TSX-3.2x2.5mm_GND(3)
R39, R43, R52, R108, R109, R113, R115: 10k; R_0402_5MIL_DWS
R41, R42, R54, R102, R103, R104, R105: 22R; R_0402_5MIL_DWS
R44, R46: 47k; R_0402_5MIL_DWS
R45: 680R/1%; R_0603_5MIL_DWS
R47, R50, R112: 2.2k; R_0402_5MIL_DWS
R49: 10k/1%; R_0402_5MIL_DWS
R51, R111: 4.7k; R_0402_5MIL_DWS
R55, R56: 1.5k; R_0402_5MIL_DWS
R60: NA(0R); R_0402_5MIL_DWS
R61: NA(10k); R_0402_5MIL_DWS
R114: 13k/1%; R_0402_5MIL_DWS
RM9A, RM9B, RM12A, RM12B: RA1206_(4x0603)_4B8_100k; R_MATRIX_4
RM9C, RM9D, RM12C, RM12D: RA1206_(4x0603)_4B8_100k; RA1206_(4X0603)_4B8_xx
U1: AllWinner-A64(FBGA396); FBGA396
U7, U8, U10: RCLAMP0524P(SLP2510P8); SLP2510P8
U9, U21: SY6280AAC(SOT23-5); SOT-23-5
U11: RTL8723BS(ComboModule); RL-SM02BD(RTL8723BS)
U12: GL850G-SO28; SSOP28
USB1: USB_A_THERES; USB-A-TERES
USB3: USB3; FLEXCON-0.5-6

Connections:
#DEBUGSELECT: U1.D20 (PL9/S-TWI-SDA/S_PL_EINT9); also elsewhere on the board
+3.3VD: C79.2, FET1.1 (G), R46.1, U1.M16 (HVCC); also elsewhere on the board
+3V3: C73.2, C91.2, C92.2, R109.2, U1.L16 (VCC-USB), U11.9 (VDD33); also elsewhere on the board
+5V: C78.1, C215.1, U9.5 (IN), U21.5 (IN); also elsewhere on the board
/USB&HDMI,WiFi&BT,Ethernet,LCD/AP-WAKE-BT: U1.B20 (PL6/S-JTAG-DO/S_PL_EINT6), U11.6 (BT_WAKE)
/USB&HDMI,WiFi&BT,Ethernet,LCD/BT-PCM-CLK: U1.AB18 (PG11/AIF3-BCLK/PCM1-BCLK/PG_EINT11), U11.26 (PCM_CLK)
/USB&HDMI,WiFi&BT,Ethernet,LCD/BT-PCM-DIN: U1.AC19 (PG12/AIF3-DOUT/PCM1-DOUT/PG_EINT12), U11.27 (PCM_DIN)
/USB&HDMI,WiFi&BT,Ethernet,LCD/BT-PCM-DOUT: U1.U22 (PG13/AIF3-DIN/PCM1-DIN/PG_EINT13), U11.25 (PCM_DOUT)
/USB&HDMI,WiFi&BT,Ethernet,LCD/BT-PCM-SYNC: U1.AB19 (PG10/AIF3-SYNC/PCM1-SYNC/PG_EINT10), U11.28 (PCM_SYNC)
/USB&HDMI,WiFi&BT,Ethernet,LCD/BT-RST-N: RM12C.3.2, U1.A20 (PL4/S-JTAG-MS/S_PL_EINT4), U11.34 (BT_DIS#); also elsewhere on the board
/USB&HDMI,WiFi&BT,Ethernet,LCD/BT-UART-CTS: U1.AC17 (PG8/UART1-RTS/PG_EINT8), U11.44 (UART_CTS)
/USB&HDMI,WiFi&BT,Ethernet,LCD/BT-UART-RX: RM12D.4.2, U1.AB17 (PG6/UART1-TX/PG_EINT6), U11.43 (UART_IN); also elsewhere on the board
/USB&HDMI,WiFi&BT,Ethernet,LCD/BT-UART-TX: U1.U23 (PG7/UART1-RX/PG_EINT7), U11.42 (UART_OUT)
/USB&HDMI,WiFi&BT,Ethernet,LCD/BT-WAKE-AP: U1.D19 (PL5/S-JTAG-CK/S_PL_EINT5), U11.7 (BT_HOST_WAKE)
/USB&HDMI,WiFi&BT,Ethernet,LCD/HCEC: FET1.2 (S), R46.2, U1.F21 (HCEC), U10.1 (IN1), U10.10 (OUT1)
/USB&HDMI,WiFi&BT,Ethernet,LCD/HHPD: R51.1, R52.1, U1.E21 (HHPD), U10.5 (IN4), U10.6 (OUT4)
/USB&HDMI,WiFi&BT,Ethernet,LCD/HSCL: HDMI1.15, R47.2, U1.G21 (HSCL), U10.2 (IN2), U10.9 (OUT2)
/USB&HDMI,WiFi&BT,Ethernet,LCD/HSDA: HDMI1.16, R50.2, U1.E20 (HSDA), U10.4 (IN3), U10.7 (OUT3)
/USB&HDMI,WiFi&BT,Ethernet,LCD/HTX0_N: HDMI1.9, U1.G23 (HTX0N), U8.2 (IN2), U8.9 (OUT2)
/USB&HDMI,WiFi&BT,Ethernet,LCD/HTX0_P: HDMI1.8, U1.G22 (HTX0P), U8.1 (IN1), U8.10 (OUT1)
/USB&HDMI,WiFi&BT,Ethernet,LCD/HTX1_N: HDMI1.6, U1.F22 (HTX1N), U7.5 (IN4), U7.6 (OUT4)
/USB&HDMI,WiFi&BT,Ethernet,LCD/HTX1_P: HDMI1.5, U1.E23 (HTX1P), U7.4 (IN3), U7.7 (OUT3)
/USB&HDMI,WiFi&BT,Ethernet,LCD/HTX2_N: HDMI1.3, U1.E22 (HTX2N), U7.2 (IN2), U7.9 (OUT2)
/USB&HDMI,WiFi&BT,Ethernet,LCD/HTX2_P: HDMI1.2, U1.D23 (HTX2P), U7.1 (IN1), U7.10 (OUT1)
/USB&HDMI,WiFi&BT,Ethernet,LCD/HTXC_N: HDMI1.12, U1.H23 (HTXCN), U8.5 (IN4), U8.6 (OUT4)
/USB&HDMI,WiFi&BT,Ethernet,LCD/HTXC_P: HDMI1.11, U1.H22 (HTXCP), U8.4 (IN3), U8.7 (OUT3)
/USB&HDMI,WiFi&BT,Ethernet,LCD/HUSB1-D+: R103.1, USB1.3
/USB&HDMI,WiFi&BT,Ethernet,LCD/HUSB1-D-: R102.1, USB1.2
/USB&HDMI,WiFi&BT,Ethernet,LCD/HUSB1-D_N: R102.2, U12.27 (DM1)
/USB&HDMI,WiFi&BT,Ethernet,LCD/HUSB1-D_P: R103.2, U12.28 (DP1)
/USB&HDMI,WiFi&BT,Ethernet,LCD/HUSB4-D+: R105.1, USB3.4
/USB&HDMI,WiFi&BT,Ethernet,LCD/HUSB4-D-: R104.1, USB3.3
/USB&HDMI,WiFi&BT,Ethernet,LCD/HUSB4-D_N: R104.2, U12.11 (DM4)
/USB&HDMI,WiFi&BT,Ethernet,LCD/HUSB4-D_P: R105.2, U12.12 (DP4)
/USB&HDMI,WiFi&BT,Ethernet,LCD/USB0-VBUSDET: C216.2, R111.1, R115.2, U1.AB4 (PH6/UART3-RTS/PH_EINT6)
/USB&HDMI,WiFi&BT,Ethernet,LCD/USB1-DRV: R108.2, U1.C19 (PL7/S-JTAG-DI/S_PL_EINT7), U9.4 (EN)
/USB&HDMI,WiFi&BT,Ethernet,LCD/USB1-D_N: U1.C22 (USB1-DM), U12.25 (DM0)
/USB&HDMI,WiFi&BT,Ethernet,LCD/USB1-D_P: U1.B23 (USB1-DP), U12.26 (DP0)
/USB&HDMI,WiFi&BT,Ethernet,LCD/WL-PMU-EN: R41.1, RM12B.2.2, U11.12 (WL_DSI#/GPIO9); also elsewhere on the board
/USB&HDMI,WiFi&BT,Ethernet,LCD/WL-SDIO-CLK: R54.2, U1.V21 (PG0/SDC1-CLK/PG_EINT0)
/USB&HDMI,WiFi&BT,Ethernet,LCD/WL-SDIO-CMD: RM9C.3.2, U1.U20 (PG1/SDC1-CMD/PG_EINT1), U11.16 (SD_CMD); also elsewhere on the board
/USB&HDMI,WiFi&BT,Ethernet,LCD/WL-SDIO-D0: RM9A.1.2, U1.U19 (PG2/SDC1-D0/PG_EINT2), U11.18 (SD_D0); also elsewhere on the board
/USB&HDMI,WiFi&BT,Ethernet,LCD/WL-SDIO-D1: RM9B.2.2, U1.V22 (PG3/SDC1-D1/PG_EINT3), U11.19 (SD_D1); also elsewhere on the board
/USB&HDMI,WiFi&BT,Ethernet,LCD/WL-SDIO-D2: RM9D.4.2, U1.Y21 (PG4/SDC1-D2/PG_EINT4), U11.14 (SD_D2); also elsewhere on the board
/USB&HDMI,WiFi&BT,Ethernet,LCD/WL-SDIO-D3: RM12A.1.2, U1.W23 (PG5/SDC1-D3/PG_EINT5), U11.15 (SD_D3); also elsewhere on the board
/USB&HDMI,WiFi&BT,Ethernet,LCD/WL-WAKE-AP: R42.1, U11.13 (WL_HOST_WAKE)
AP-CK32KO: R60.2, R61.1; also elsewhere on the board
GND: ANT1.2, C68.1, C73.1, C74.2, C75.2, C76.2, C77.1, C78.2, C79.1, C81.2, C82.2, C83.2, C85.1, C86.2, C87.2, C88.2, C89.1, C90.1, C91.1, C92.1, C94.2, C106.1, C107.1, C109.2, C110.1, C212.2, C213.1, C214.1, C215.2, C216.1, HDMI1.0, HDMI1.1, HDMI1.4, HDMI1.7, HDMI1.10, HDMI1.13, HDMI1.SH1 (20), HDMI1.SH2 (21), HDMI1.SH3 (22), HDMI1.SH4 (23), L9.1, Q1.3 (case), R45.1, R49.1, R52.2, R55.2, R56.2, R108.1, R112.2, R113.1, R114.1, R115.1, U7.3 (GND), U7.8 (GND), U8.3 (GND), U8.8 (GND), U9.2 (GND), U10.3 (GND), U10.8 (GND), U11.1 (GND), U11.20 (GND), U11.31 (GND), U11.33 (GND), U11.36 (GND), U11.41 (GND), U12.14 (TEST/SCL), U12.15 (GND), U21.2 (GND), USB1.4, USB3.0, USB3.5, USB3.6; also elsewhere on the board
HUSB2-D_N: U12.2 (DM2); also elsewhere on the board
HUSB2-D_P: U12.3 (DP2); also elsewhere on the board
HUSB3-D_N: U12.8 (DM3); also elsewhere on the board
HUSB3-D_P: U12.9 (DP3); also elsewhere on the board
LED_CAPS: LED1.2 (A); also elsewhere on the board
LED_NUML: LED2.2 (A); also elsewhere on the board
LIDSW: U1.B21 (PL8/S-TWI-SCK/S_PL_EINT8); also elsewhere on the board
unnamed: ANT1.1, C107.2, L13.2
unnamed: C74.1, L8.2, USB1.1
unnamed: C75.1, C82.1, C83.1, L10.2, U12.1 (AVDD), U12.5 (AVDD), U12.10 (AVDD)
unnamed: C76.1, C81.1, L10.1, R43.1, R44.1, U12.16 (DVDD), U12.24 (V33)
unnamed: C87.1, R39.2, U12.13 (#RESET)
unnamed: C88.1, Q1.1, U12.6 (X1)
unnamed: C94.1, Q1.2, U12.7 (X2)
unnamed: C105.1, U11.2 (WIFI/BT_ANT)
unnamed: C105.2, C106.2, L13.1
unnamed: C213.2, C214.2, L6.1, R111.2, U21.1 (OUT)
unnamed: FET1.3 (D), HDMI1.14
unnamed: FUSE1.2, HDMI1.18
unnamed: HDMI1.19, R51.2
unnamed: L9.2, USB1.0, USB1.SH (5)
unnamed: LED1.1 (K), R55.1
unnamed: LED2.1 (K), R56.1
unnamed: R41.2, U1.A19 (PL2/S-UART-TX/S_PL_EINT2)
unnamed: R42.2, U1.E19 (PL3/S-UART-RX/S_PL_EINT3)
unnamed: R43.2, U12.17 (PSELF)
unnamed: R44.2, U12.18 (PGANG)
unnamed: R45.2, U12.4 (RREF)
unnamed: R49.2, U9.3 (ISET)
unnamed: R54.1, U11.17 (SD_CLK)
unnamed: R60.1, U11.24 (SUSCLK_IN/GPIO6)
unnamed: R112.1, U1.U21 (PG9/UART1-CTS/PG_EINT9)
unnamed: R114.2, U21.3 (ISET)
PA-ENABLE: U1.D22 (PL12/S_PL_EINT12); also elsewhere on the board
PH4: U1.AB5 (PH4/UART3-TX/PH_EINT4); also elsewhere on the board
PH5: U1.AC7 (PH5/UART3-RX/PH_EINT5); also elsewhere on the board
PH7: U1.AC5 (PH7/UART3-CTS/PH_EINT7); also elsewhere on the board
PH8: U1.Y10 (PH8/SPDIF-OUT/PH_EINT8); also elsewhere on the board
PH10: U1.Y8 (PH10/MIC-CLK/PH_EINT10); also elsewhere on the board
PH11: U1.AA5 (PH11/MIC-DATA/PH_EINT11); also elsewhere on the board
PL10: U1.D21 (PL10/S-PWM/S_PL_EINT10); also elsewhere on the board
PL11: U1.C20 (PL11/S-CIR-RX/S_PL_EINT11); also elsewhere on the board
PMU-SCK: U1.D17 (PL0/S-RSB-SCK/S-TWI-SCK/S_PL_EINT0); also elsewhere on the board
PMU-SDA: U1.C17 (PL1/S-RSB-SDA/S-TWI-SDA); also elsewhere on the board
TWI0-SCK: U1.W11 (PH0/TWI0-SCK/PH_EINT0); also elsewhere on the board
TWI0-SDA: U1.AA10 (PH1/TWI0-SDA/PH_EINT1); also elsewhere on the board
TWI1-SCK: U1.AC4 (PH2/TWI1-SCK/PH_EINT2); also elsewhere on the board
TWI1-SDA: U1.AA9 (PH3/TWI1-SDA/PH_EINT3); also elsewhere on the board
USB0-DRV: R113.2, U21.4 (EN); also elsewhere on the board
USB0-D_N: U1.B22 (USB0-DM); also elsewhere on the board
USB0-D_P: U1.A22 (USB0-DP); also elsewhere on the board
USB0-ID: R109.1, U1.AA8 (PH9/PH_EINT9); also elsewhere on the board
USB5V: C68.2, C77.2, C85.2, C86.1, FUSE1.1, L8.1, R39.1, R47.1, R50.1, U9.1 (OUT), U12.23 (V5), USB3.1, USB3.2; also elsewhere on the board
USB5VOTG: C212.1, L6.2; also elsewhere on the board
VCC-PL: C89.2, C90.2, C109.1, C110.2, R61.2, RM9A.1.1, RM9B.2.1, RM9C.3.1, RM9D.4.1, RM12A.1.1, RM12B.2.1, RM12C.3.1, RM12D.4.1, U1.J16 (VCC-PL), U1.T17 (VCC-PG), U11.22 (VDD_IO); also elsewhere on the board

Notes on the sheet:
Z=100R
Rset
Ilim=0.680A
reserved for digital mic
WiFi&BT
HDMI
To ALDO2
USB
To DLDO4
Ilim=0.5A
HUB
Ilim(A)=6800/Rset(Ohm)
To DLDO1
Z=90R
spdif out
KEYBOARD & TOUCHPAD
