cosmopotamian/DIY-LAPTOP/HARDWARE/A64-TERES/TERES-PCB1-A64-MAIN/Rev.C/TERES_PCB1-A64-MAIN_Rev.C.kicad_pcb

## KiCad design HARDWARE/A64-TERES/TERES-PCB1-A64-MAIN/Rev.C/TERES_PCB1-A64-MAIN_Rev.C.kicad_pcb (continued)

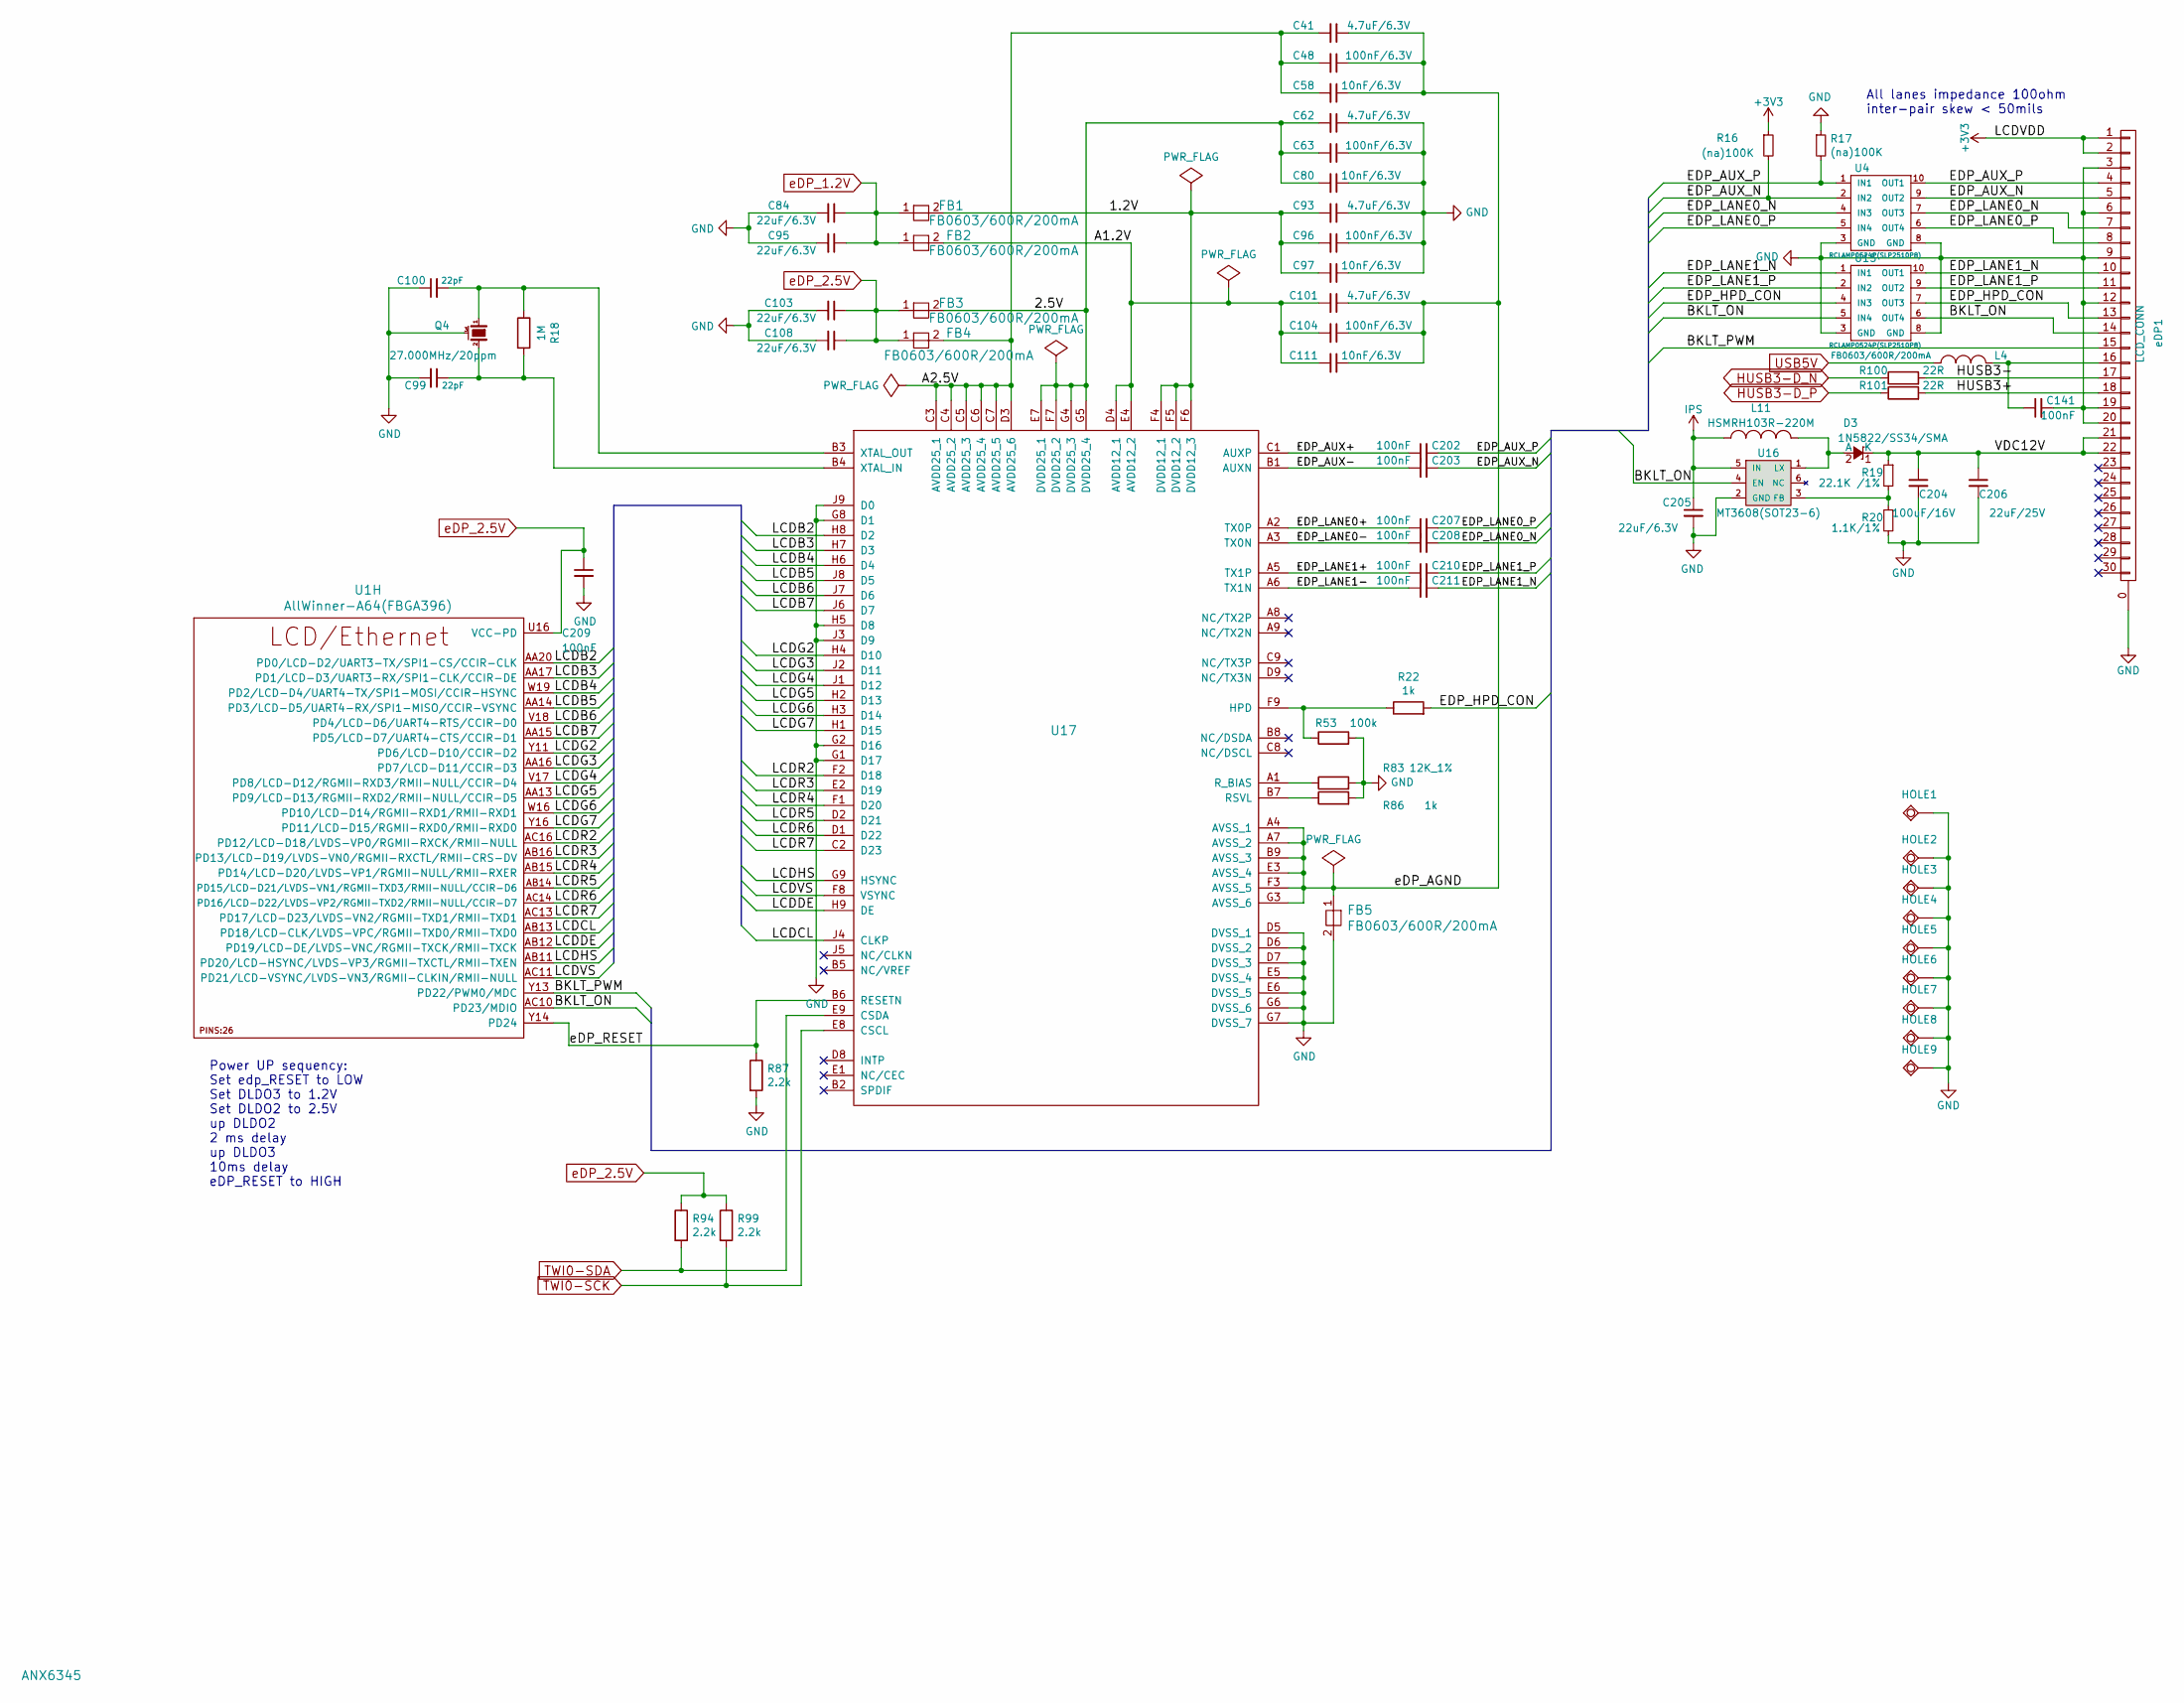
[picture p6: schematic LCD.kicad_sch]

Parts:
C41, C62, C93, C101: 4.7uF/6.3V; C_0603_5MIL_DWS
C48, C63, C96, C104: 100nF/6.3V; C_0402_5MIL_DWS
C58, C80, C97, C111: 10nF/6.3V; C_0402_5MIL_DWS
C84, C95, C103, C108, C205: 22uF/6.3V; C_0603_5MIL_DWS
C99, C100: 22pF; C_0402_5MIL_DWS
C141, C202, C203, C207, C208, C209, C210, C211: 100nF; C_0402_5MIL_DWS
C204: 100uF/16V; C_1206_5MIL_DWS
C206: 22uF/25V; C_1206_5MIL_DWS
D3: 1N5822/SS34/SMA; SMA-KA
FB1, FB2, FB3, FB4, FB5: FB0603/600R/200mA; L_0603_5MIL_DWS
HOLE1, HOLE2, HOLE3, HOLE4, HOLE5, HOLE6, HOLE7, HOLE8, HOLE9: TESTPAD; Oval_Drill
L4: FB0603/600R/200mA; L_0603_5MIL_DWS
L11: HSMRH103R-220M; HSMRH103R
Q4: 27.000MHz/20ppm; TSX-3.2x2.5mm_GND(3)
R16, R17: (na)100K; R_0402_5MIL_DWS
R18: 1M; R_0402_5MIL_DWS
R19: 22.1K /1%; R_0402_5MIL_DWS
R20: 1.1K/1%; R_0402_5MIL_DWS
R22, R86: 1k; R_0402_5MIL_DWS
R53: 100k; R_0402_5MIL_DWS
R83: 12K_1%; R_0402_5MIL_DWS
R87, R94, R99: 2.2k; R_0402_5MIL_DWS
R100, R101: 22R; R_0402_5MIL_DWS
U1: AllWinner-A64(FBGA396); FBGA396
U4, U15: RCLAMP0524P(SLP2510P8); SLP2510P8
U16: MT3608(SOT23-6); SOT23-6
U17: ANX6345; BGA_8x8mm_81p_0.8
eDP1: LCD_CONN; eDP-TERES

Connections:
+3V3: R16.1, eDP1.1, eDP1.2; also elsewhere on the board
/eDP LCD/1.2V: C93.2, C96.2, C97.2, FB1.2, U17.F4 (DVDD12_1), U17.F5 (DVDD12_2), U17.F6 (DVDD12_3)
/eDP LCD/2.5V: C62.2, C63.2, C80.2, FB3.2, U17.E7 (DVDD25_1), U17.F7 (DVDD25_2), U17.G4 (DVDD25_3), U17.G5 (DVDD25_4)
/eDP LCD/A1.2V: C101.2, C104.2, C111.2, FB2.2, U17.D4 (AVDD12_1), U17.E4 (AVDD12_2)
/eDP LCD/A2.5V: C41.2, C48.2, C58.2, FB4.2, U17.C3 (AVDD25_1), U17.C4 (AVDD25_2), U17.C5 (AVDD25_3), U17.C6 (AVDD25_4), U17.C7 (AVDD25_5), U17.D3 (AVDD25_6)
/eDP LCD/BKLT_ON: U1.AC10 (PD23/MDIO), U15.5 (IN4), U15.6 (OUT4), U16.4 (EN), eDP1.14
/eDP LCD/BKLT_PWM: U1.Y13 (PD22/PWM0/MDC), eDP1.15
/eDP LCD/EDP_AUX+: C202.1, U17.C1 (AUXP)
/eDP LCD/EDP_AUX-: C203.1, U17.B1 (AUXN)
/eDP LCD/EDP_AUX_N: C203.2, R16.2, U4.2 (IN2), U4.9 (OUT2), eDP1.5
/eDP LCD/EDP_AUX_P: C202.2, R17.2, U4.1 (IN1), U4.10 (OUT1), eDP1.4
/eDP LCD/EDP_HPD_CON: R22.2, U15.4 (IN3), U15.7 (OUT3), eDP1.13
/eDP LCD/EDP_LANE0+: C207.1, U17.A2 (TX0P)
/eDP LCD/EDP_LANE0-: C208.1, U17.A3 (TX0N)
/eDP LCD/EDP_LANE0_N: C208.2, U4.4 (IN3), U4.7 (OUT3), eDP1.7
/eDP LCD/EDP_LANE0_P: C207.2, U4.5 (IN4), U4.6 (OUT4), eDP1.8
/eDP LCD/EDP_LANE1+: C210.1, U17.A5 (TX1P)
/eDP LCD/EDP_LANE1-: C211.1, U17.A6 (TX1N)
/eDP LCD/EDP_LANE1_N: C211.2, U15.1 (IN1), U15.10 (OUT1), eDP1.10
/eDP LCD/EDP_LANE1_P: C210.2, U15.2 (IN2), U15.9 (OUT2), eDP1.11
/eDP LCD/HUSB3+: R101.2, eDP1.18
/eDP LCD/HUSB3-: R100.2, eDP1.17
/eDP LCD/LCDB2: U1.AA20 (PD0/LCD-D2/UART3-TX/SPI1-CS/CCIR-CLK), U17.H8 (D2)
/eDP LCD/LCDB3: U1.AA17 (PD1/LCD-D3/UART3-RX/SPI1-CLK/CCIR-DE), U17.H7 (D3)
/eDP LCD/LCDB4: U1.W19 (PD2/LCD-D4/UART4-TX/SPI1-MOSI/CCIR-HSYNC), U17.H6 (D4)
/eDP LCD/LCDB5: U1.AA14 (PD3/LCD-D5/UART4-RX/SPI1-MISO/CCIR-VSYNC), U17.J8 (D5)
/eDP LCD/LCDB6: U1.V18 (PD4/LCD-D6/UART4-RTS/CCIR-D0), U17.J7 (D6)
/eDP LCD/LCDB7: U1.AA15 (PD5/LCD-D7/UART4-CTS/CCIR-D1), U17.J6 (D7)
/eDP LCD/LCDCL: U1.AB13 (PD18/LCD-CLK/LVDS-VPC/RGMII-TXD0/RMII-T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), U17.J4 (CLKP)
/eDP LCD/LCDDE: U1.AB12 (PD19/LCD-DE/LVDS-VNC/RGMII-TXCK/RMII-TX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), U17.H9 (DE)
/eDP LCD/LCDG2: U1.Y11 (PD6/LCD-D10/CCIR-D2), U17.H4 (D10)
/eDP LCD/LCDG3: U1.AA16 (PD7/LCD-D11/CCIR-D3), U17.J2 (D11)
/eDP LCD/LCDG4: U1.V17 (PD8/LCD-D12/RGMII-RXD3/RMII-NULL/CCIR-D4), U17.J1 (D12)
/eDP LCD/LCDG5: U1.AA13 (PD9/LCD-D13/RGMII-RXD2/RMII-NULL/CCIR-D5), U17.H2 (D13)
/eDP LCD/LCDG6: U1.W16 (PD10/LCD-D14/RGMII-RXD1/RMII-RXD1), U17.H3 (D14)
/eDP LCD/LCDG7: U1.Y16 (PD11/LCD-D15/RGMII-RXD0/RMII-RXD0), U17.H1 (D15)
/eDP LCD/LCDHS: U1.AB11 (PD20/LCD-HSYNC/LVDS-VP3/RGMII-TXCTL/RMI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), U17.G9 (HSYNC)
/eDP LCD/LCDR2: U1.AC16 (PD12/LCD-D18/LVDS-VP0/RGMII-RXCK/RMII-N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), U17.F2 (D18)
/eDP LCD/LCDR3: U1.AB16 (PD13/LCD-D19/LVDS-VN0/RGMII-RXCTL/RMII-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), U17.E2 (D19)
/eDP LCD/LCDR4: U1.AB15 (PD14/LCD-D20/LVDS-VP1/RGMII-NULL/RMII-R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), U17.F1 (D20)
/eDP LCD/LCDR5: U1.AB14 (PD15/LCD-D21/LVDS-VN1/RGMII-TXD3/RMII-N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), U17.D2 (D21)
/eDP LCD/LCDR6: U1.AC14 (PD16/LCD-D22/LVDS-VP2/RGMII-TXD2/RMII-N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), U17.D1 (D22)
/eDP LCD/LCDR7: U1.AC13 (PD17/LCD-D23/LVDS-VN2/RGMII-TXD1/RMII-T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), U17.C2 (D23)
/eDP LCD/LCDVS: U1.AC11 (PD21/LCD-VSYNC/LVDS-VN3/RGMII-CLKIN/RMI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), U17.F8 (VSYNC)
/eDP LCD/VDC18V: C204.1, C206.1, D3.1 (K), R19.1, eDP1.21, eDP1.22
/eDP LCD/eDP_AGND: C41.1, C48.1, C58.1, C101.1, C104.1, C111.1, FB5.1, U17.A4 (AVSS_1), U17.A7 (AVSS_2), U17.B9 (AVSS_3), U17.E3 (AVSS_4), U17.F3 (AVSS_5), U17.G3 (AVSS_6)
/eDP LCD/eDP_RESET: R87.1, U1.Y14 (PD24), U17.B6 (RESETN)
GND: C62.1, C63.1, C80.1, C84.2, C93.1, C95.2, C96.1, C97.1, C99.2, C100.1, C103.2, C108.2, C141.2, C204.2, C205.2, C206.2, C209.2, FB5.2, HOLE1.1, HOLE2.1, HOLE3.1, HOLE4.1, HOLE5.1, HOLE6.1, HOLE7.1, HOLE8.1, HOLE9.1, Q4.3 (case), R17.1, R20.2, R53.2, R83.2, R86.2, R87.2, U4.3 (GND), U4.8 (GND), U15.3 (GND), U15.8 (GND), U16.2 (GND), U17.D5 (DVSS_1), U17.D6 (DVSS_2), U17.D7 (DVSS_3), U17.E5 (DVSS_4), U17.E6 (DVSS_5), U17.G1 (D17), U17.G2 (D16), U17.G6 (DVSS_6), U17.G7 (DVSS_7), U17.G8 (D1), U17.H5 (D8), U17.J3 (D9), U17.J9 (D0), eDP1.0, eDP1.3, eDP1.6, eDP1.9, eDP1.12, eDP1.19, eDP1.20; also elsewhere on the board
HUSB3-D_N: R100.1; also elsewhere on the board
HUSB3-D_P: R101.1; also elsewhere on the board
IPS: C205.1, L11.1, U16.5 (IN); also elsewhere on the board
unnamed: C99.1, Q4.2, R18.2, U17.B4 (XTAL_IN)
unnamed: C100.2, Q4.1, R18.1, U17.B3 (XTAL_OUT)
unnamed: C141.1, L4.1, eDP1.16
unnamed: D3.2 (A), L11.2, U16.1 (LX)
unnamed: R19.2, R20.1, U16.3 (FB)
unnamed: R22.1, R53.1, U17.F9 (HPD)
unnamed: R83.1, U17.A1 (R_BIAS)
unnamed: R86.1, U17.B7 (RSVL)
TWI0-SCK: R99.2, U17.E8 (CSCL); also elsewhere on the board
TWI0-SDA: R94.2, U17.E9 (CSDA); also elsewhere on the board
USB5V: L4.2; also elsewhere on the board
eDP_1.2V: C84.1, C95.1, FB1.1, FB2.1; also elsewhere on the board
eDP_2.5V: C103.1, C108.1, C209.1, FB3.1, FB4.1, R94.1, R99.1, U1.U16 (VCC-PD); also elsewhere on the board

Notes on the sheet:
Power UP sequency: Set edp_RESET to LOW Set DLDO3 to 1.2V Set DLDO2 to 2.5V up DLDO2 2 ms delay up DLDO3 10ms delay eDP_RESET to HIGH
All lanes impedance 100ohm inter-pair skew < 50mils

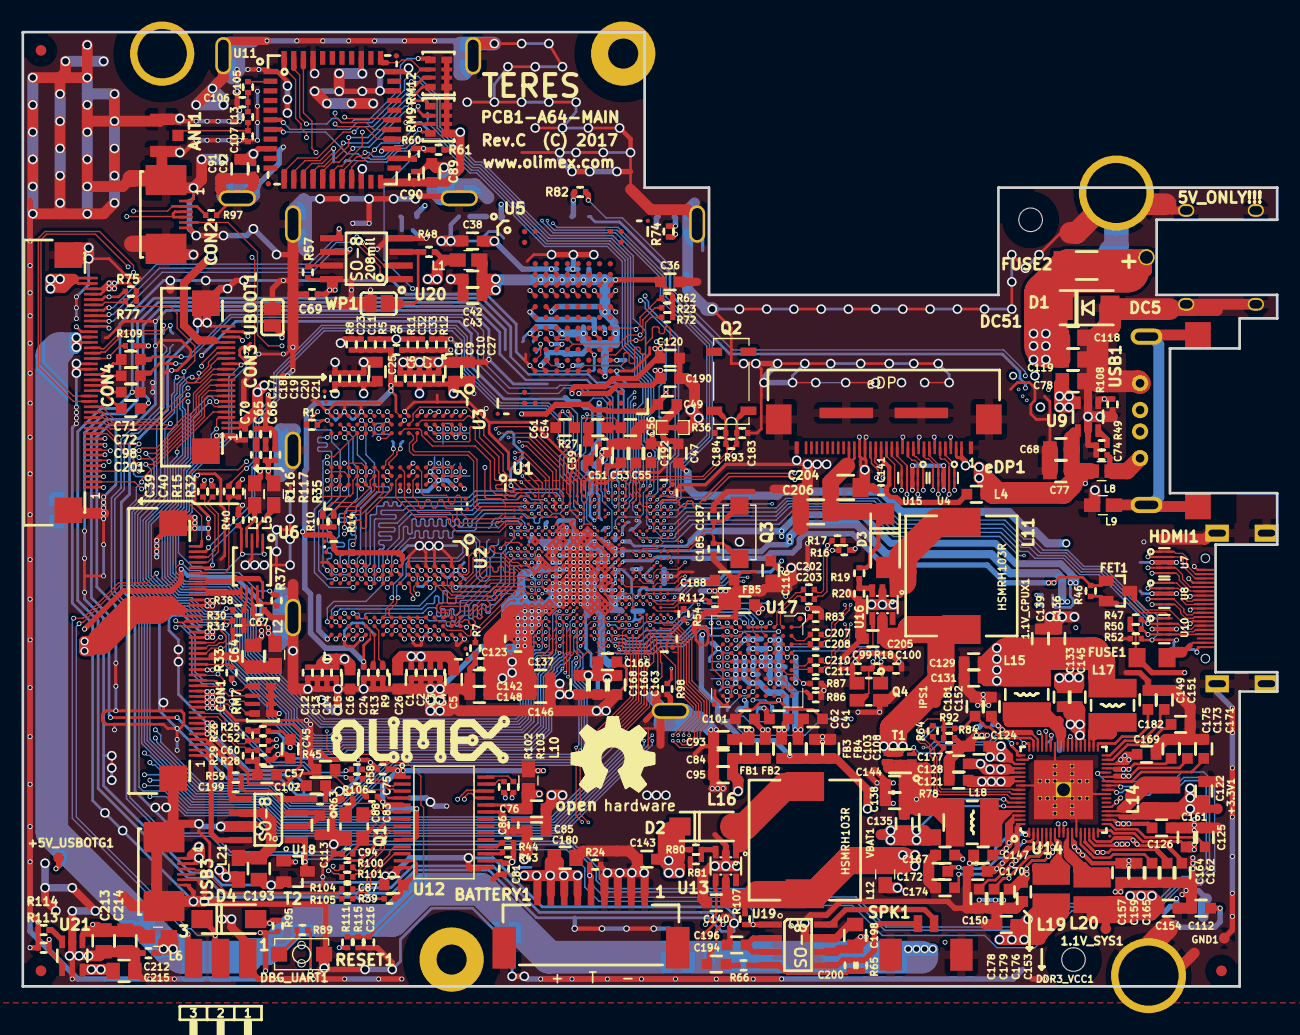
[picture p7: board TERES_PCB1-A64-MAIN_Rev.C.kicad_pcb from above]

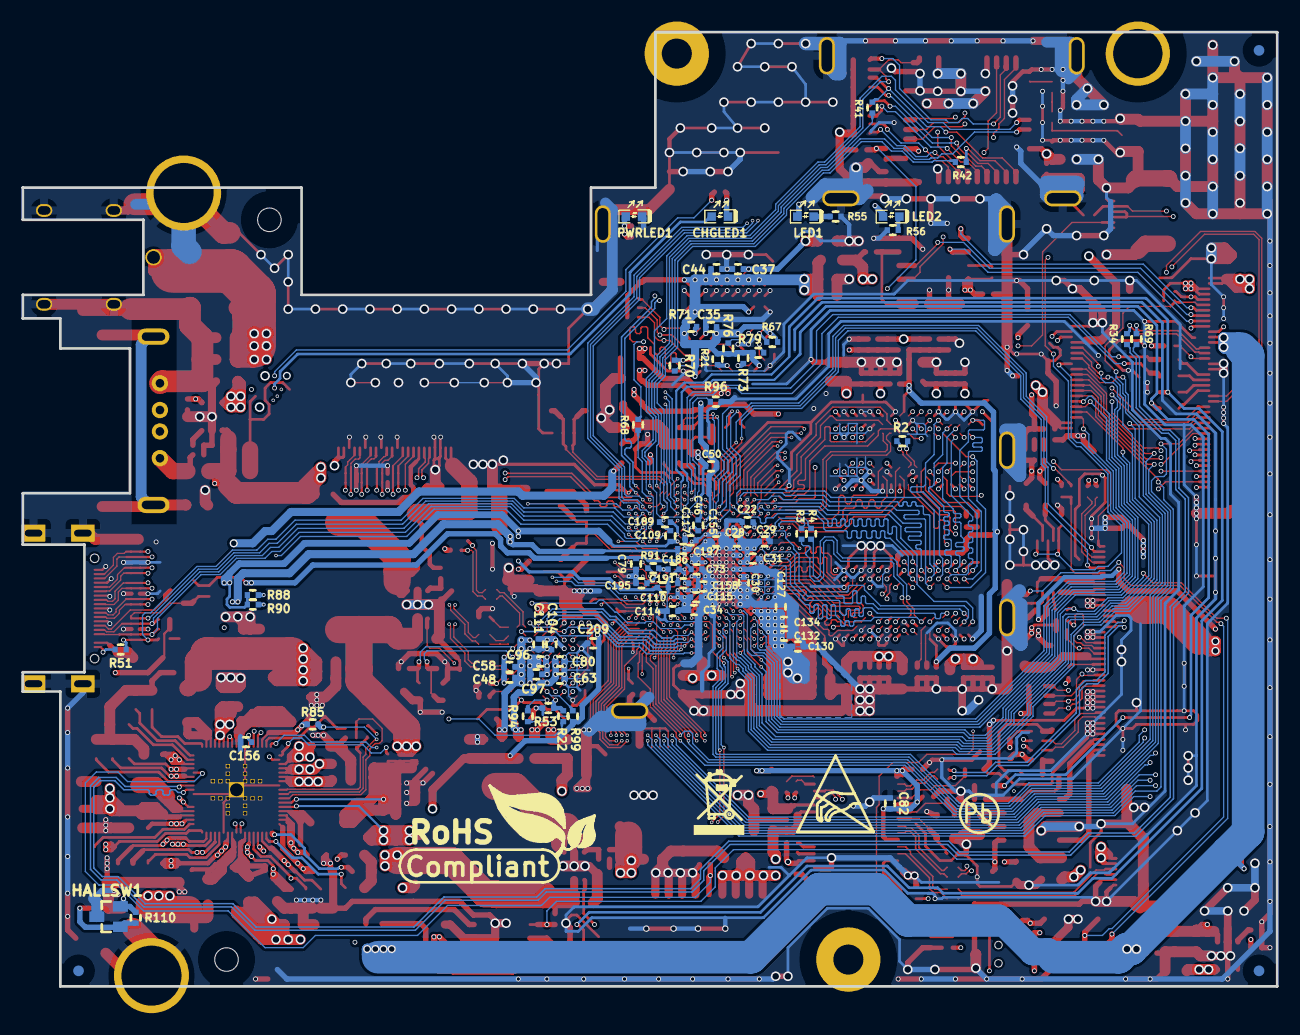
[picture p8: board TERES_PCB1-A64-MAIN_Rev.C.kicad_pcb from below]

Board: 6 copper layers, 117.0 x 89.0 mm, 443 parts (75 on the bottom side), 414 nets.

Other parts of the board:
MountingHole: Mounting_hole_3.3mm; Mounting_hole_5.6mm_TERES
MountingHole#2: Mounting_hole_3.3mm; Mounting_hole_5.6mm_TERES
MountingHole#3: Mounting_hole_3.3mm
MountingHole#4: Mounting_hole_3.3mm; Mounting_hole_2.8mm
MountingHole#5: Mounting_hole_3.3mm; Mounting_hole_TERES_4.6mm
MountingHole#6, MountingHole#7: Mounting_hole_3.3mm; NPTH_2.2mm
RM7, RM9, RM12: RA1206_(4x0603)_4B8_100k; R_MATRIX_4
Ref**: Val**; LOGO_ANTISTATIC_1
Ref**#2: Val**; LOGO_ROHS_1

Their connections:
+3V3: RM7.1.1, RM7.2.1, RM7.3.1, RM7.4.1; also elsewhere on the board
/NAND Flash , eMMC, T-Card and Audio/SDC0-D0: RM7.3.2; also elsewhere on the board
/NAND Flash , eMMC, T-Card and Audio/SDC0-D1: RM7.2.2; also elsewhere on the board
/NAND Flash , eMMC, T-Card and Audio/SDC0-D2: RM7.4.2; also elsewhere on the board
/NAND Flash , eMMC, T-Card and Audio/SDC0-DET#: RM7.1.2; also elsewhere on the board
/USB&HDMI,WiFi&BT,Ethernet,LCD/BT-RST-N: RM12.3.2; also elsewhere on the board
/USB&HDMI,WiFi&BT,Ethernet,LCD/BT-UART-RX: RM12.4.2; also elsewhere on the board
/USB&HDMI,WiFi&BT,Ethernet,LCD/WL-PMU-EN: RM12.2.2; also elsewhere on the board
/USB&HDMI,WiFi&BT,Ethernet,LCD/WL-SDIO-CMD: RM9.3.2; also elsewhere on the board
/USB&HDMI,WiFi&BT,Ethernet,LCD/WL-SDIO-D0: RM9.1.2; also elsewhere on the board
/USB&HDMI,WiFi&BT,Ethernet,LCD/WL-SDIO-D1: RM9.2.2; also elsewhere on the board
/USB&HDMI,WiFi&BT,Ethernet,LCD/WL-SDIO-D2: RM9.4.2; also elsewhere on the board
/USB&HDMI,WiFi&BT,Ethernet,LCD/WL-SDIO-D3: RM12.1.2; also elsewhere on the board
VCC-PL: RM9.1.1, RM9.2.1, RM9.3.1, RM9.4.1, RM12.1.1, RM12.2.1, RM12.3.1, RM12.4.1; also elsewhere on the board
